someonelse20/farsight-rc/README.md

# Farsight RC

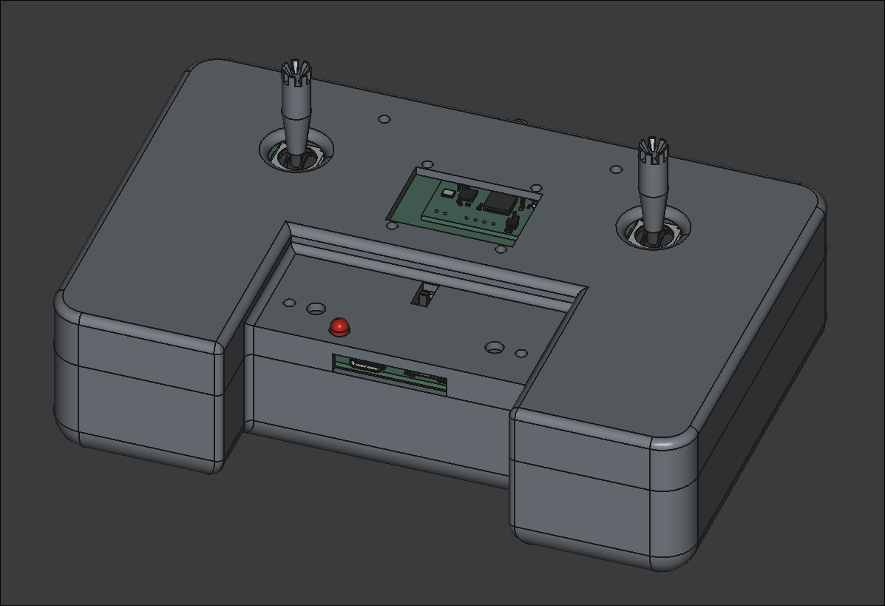
[picture p1: assets/controller-3d.png]


Custom long range remote controller with ESP32 to stream telemetry and an STM32 based lora module with the SX1262. The controller has a build in 18650 battery with an integrated charger. The transceiver is its own standalone board and can be used independenly of the controller. I made this project as a part of my larger goal to make a custom drone. I originally was going to make it out of stock modules but decided to design custom pcbs.

## Usage

**--This is still under development and is subject to change--**

### Controller

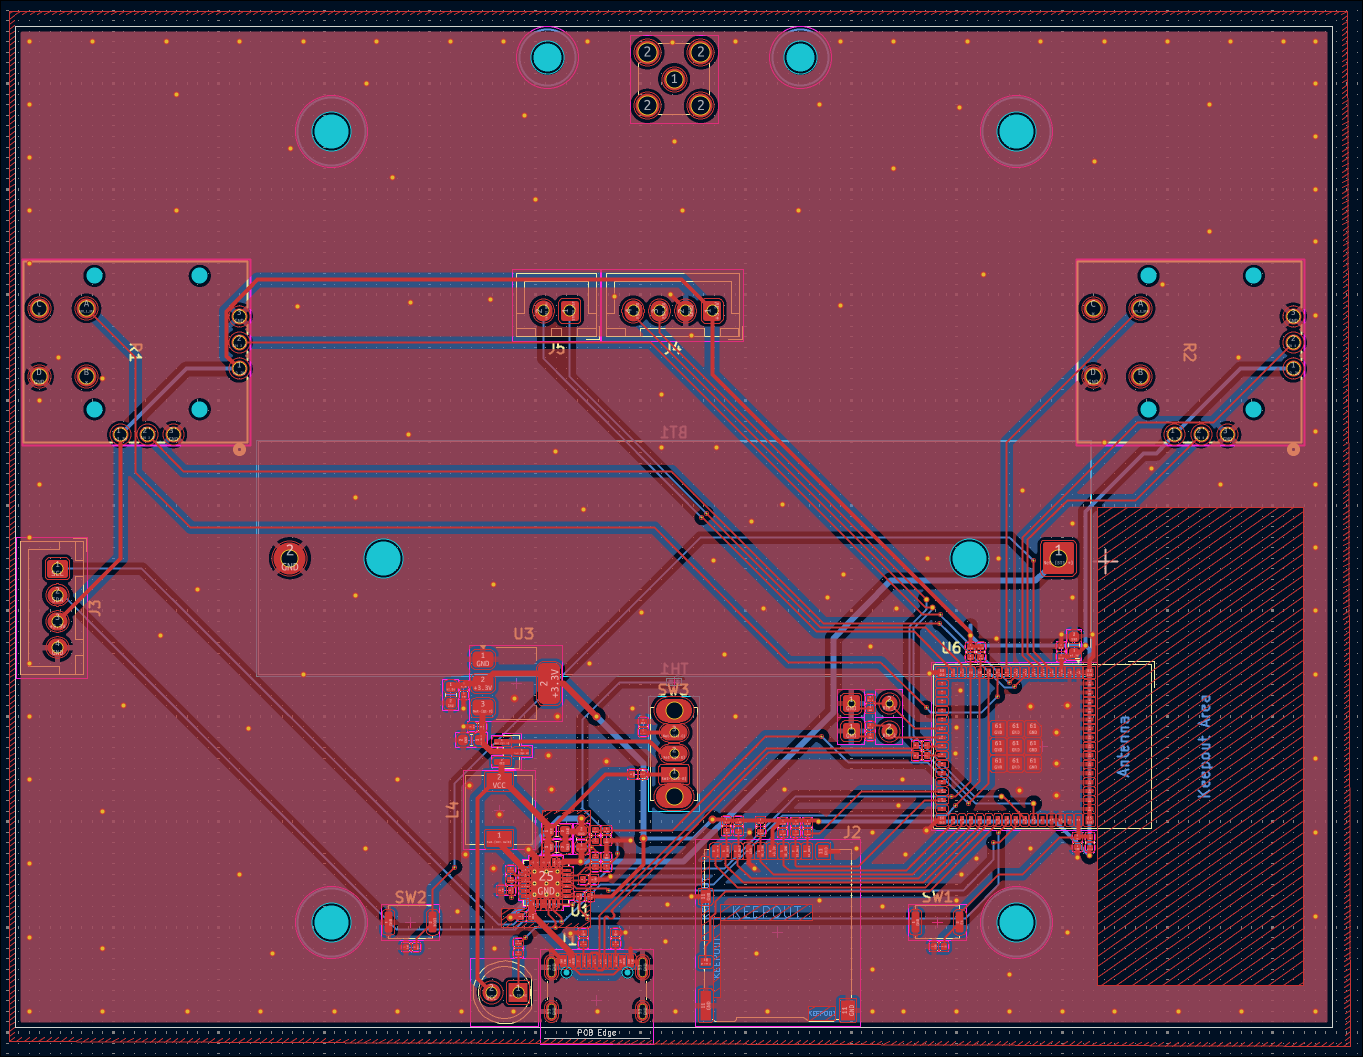
[picture p2: assets/controller_pcb.png]


The switch in the middle of the controller is the power switch and the led is the status of the battery charging. The usb connecter will charge the battery and can be used to communicate with the ESP32. The micro SD card will log all the incoming telemetry.

The controller software is currently pretty basic and missing some fetures. The wifi network the esp32 will create can be configured by installing the espressive ide and running idf.py menuconfig and changing the wifi ssid and password under Wifi Configuration. Requesting /telemetry of the ip of the nextork will return a set of comma separated values in the format of "altitude_meters,speed_meters_per_second,heading_degrees,latitude,longitude".

### Transceiver

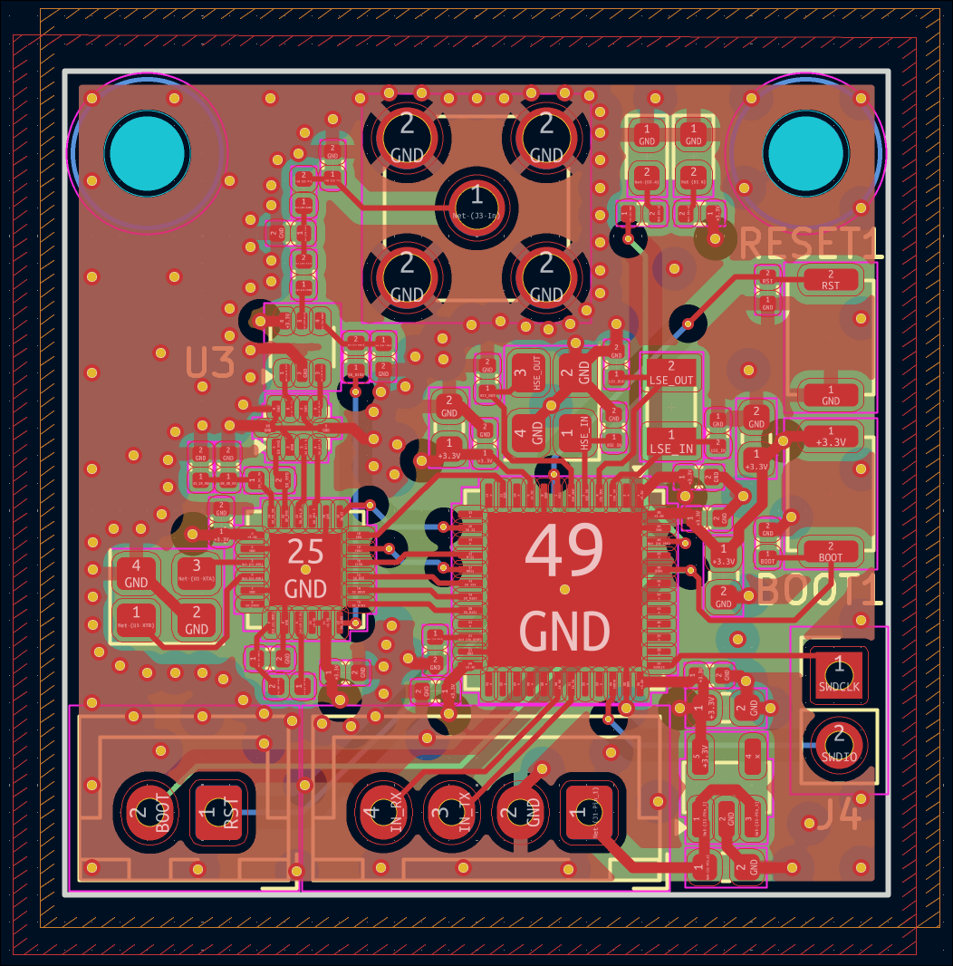
[picture p3: assets/transceiver_pcb.png]


UART pinout:
| 1 | 2 | 3 | 4 |
|-----|-----|----|----|
| VCC | GND | RX | TX |

Microcontroller pinout:
| 1 | 2 |
|---|---|
| RESET | BOOT |

Debug pinout:
| 1 | 2 |
|---|---|
| SWDCLK | SWDIO |

The transceiver has an internal regulator and can handle up to 5v input. The UART pinout is from the transceiver reference so an external device would put its Tx to the transceiver Rx and vice versa. The buttons on the board will put the STM32 into boot and reset mode respectively and the external pins are directly wired to the microcontroller.

The transceiver is built on the [Semtech SX1262 driver](https://github.com/Lora-net/sx126x_driver). To communicate with the transceiver a host must first send a register bit and then the data to transmit or receive based on the table below.
| Address | Name | Description | Input/Output | Size | Note |
|---|---|---|---|---|---|
| 0 | who_am_i | Device ID | O | 1 | Device ID is 126 |
| 1 | TX | Transmits packet | I | - | First send size byte then send data byte. |
| 2 | RX | Receives packet | I/O | - | First send size byte then send data byte. |
| 3 | TX_set | Transmits packet | I | - | Packet size must always be payload_len. |
| 4 | RX_set | Receives packet | O | - | Packet size must always be payload_len. |
| 5 | sleep | Puts transceiver into sleep mode | - | 0 | |
| 6 | wakeup | Wakes up transceiver | - | 0 | |
| 7 | set_all | Inputs a setting struct | I | TBD | See [settings_t](https://github.com/someonelse20/remote-controller/blob/main/software/transceiver/Core/Inc/uart_reg.h#L29) |
| 8 | set_frequency | Sets SX1262 frequency | I | 4 | See [sx126x_set_rf_freq](https://github.com/Lora-net/sx126x_driver/blob/master/src/sx126x.h#L1084) |
| 9 | set_tx_params | Sets SX1262 TX power and ramp time | I | 2 | array of {power in dBm, ramp time ([see datasheet](https://semtech.my.salesforce.com/sfc/p/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]))} |
| 10 | set_lora_mod_params | Sets LoRa parameters | I | TBD | See [sx126x_mod_params_lora_t](https://github.com/Lora-net/sx126x_driver/blob/master/src/sx126x.h#L381) |
| 11 | set_lora_pkt_params | Sets LoRa packet parameters | I | TBD | See [sx126x_pkt_params_lora_t](https://github.com/Lora-net/sx126x_driver/blob/master/src/sx126x.h#L454) |
| 12 | set_lora_symb_nb_timeout | Sets loRa timeout in symbols | I | 1 | See [sx126x_set_lora_symb_nb_timeout](https://github.com/Lora-net/sx126x_driver/blob/master/src/sx126x.h#L1236) |
| 13 | set_encrypt_params | Sets encryption parameters | I | - | Not currently implemented |
| 14 | enable_encrypt | Enables/disables encryption | I | - | Not currently implemented |

TBD means that the size is based on the size of a struct which will be calculated when I can run the code on the hardware.

## BOM

BOM to make two transceivers and two controllers but with only two antennas and one micro SD card.
All prices in USD. Price column is total price and does not include shipping.
| Item | Quantity | Price | Link |
|---|---|---|---|
| Controller pcb | 2 | 49.99 | https://jlcpcb.com |
| Transceiver | 2 | 87.36 | https://jlcpcb.com |
| RF filter | 2 | 0.92 | https://www.digikey.com/en/products/detail/johanson-technology-inc/0900FM15K0039001E/16639329 |
| ESP32-S3 | 2 | 5.28 | https://www.digikey.com/en/products/detail/espressif-systems/ESP32-S3-MINI-1-N8/15295890 |
| Thermistor | 2 | 0.20 | https://www.digikey.com/en/products/detail/tdk-corporation/NTCG103JF103FT1/614628 |
| Joystick | 2 | 6.08 | https://www.digikey.com/en/products/detail/c-k/THB001P/11687191 |
| RP-SMA connector | 2 | 7.40 | https://www.digikey.com/en/products/detail/taoglas-limited/PCB-RPSMAFRA-HT/5034735 |
| Antenna | 2 | 23.14 | https://www.digikey.com/en/products/detail/te-connectivity-linx/ANT-915-IPW1-RPS/15293389 |
| Power switch | 2 | 1.46 | https://www.digikey.com/en/products/detail/c-k/OS102011MS2QN1/411602 |
| Battery | 2 | 6.5 | https://www.18650batterystore.com/products/samsung-30q |
| Battery Holder | 2 | 5.56 | https://www.digikey.com/en/products/detail/mpd-memory-protection-devices/BK-18650-PC2/2079908 |
| MicroSD card | 1 | 9.99 | https://www.amazon.com/Adapter-Memory-Tablet-Console-TF162/dp/B0CYT2KL98 |
| ST-Link V2 | 1 | 9.49 | https://www.amazon.com/HiLetgo-Emulator-Downloader-Programmer-STM32F103C8T6/dp/B07SQV6VLZ |
| OLED display | 1 | 6.99 | https://www.amazon.com/UCTRONICS-SSD1306-Self-Luminous-Display-Raspberry/dp/B072Q2X2LL |
