someonelse20/farsight-rc/assets/controller_pcb-3d.png

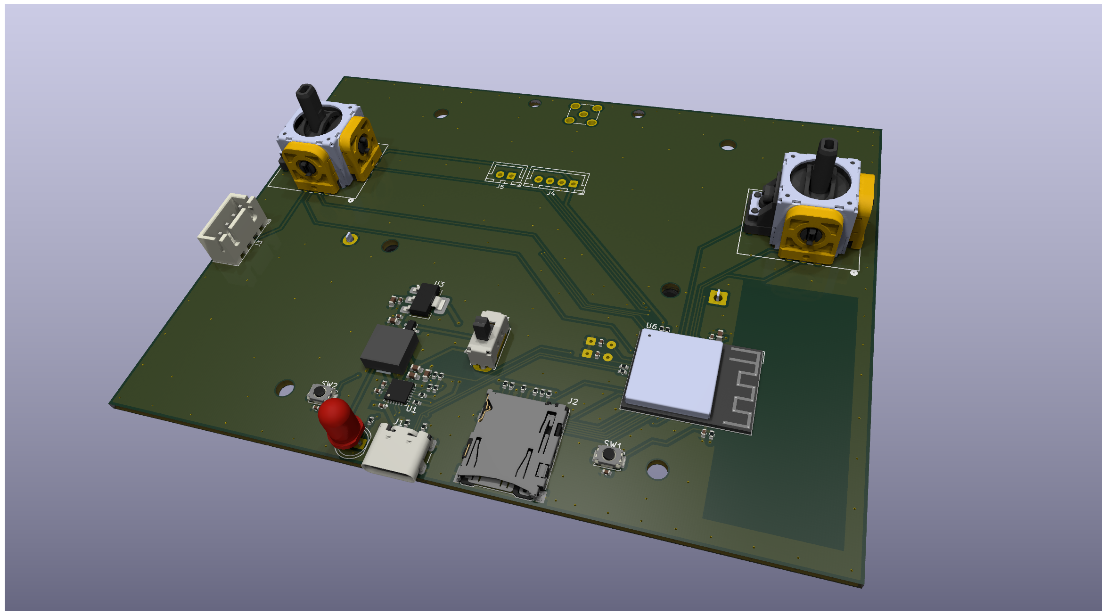
assets/controller_pcb-3d.png
