someonelse20/farsight-rc/assets/controller_schematic.png

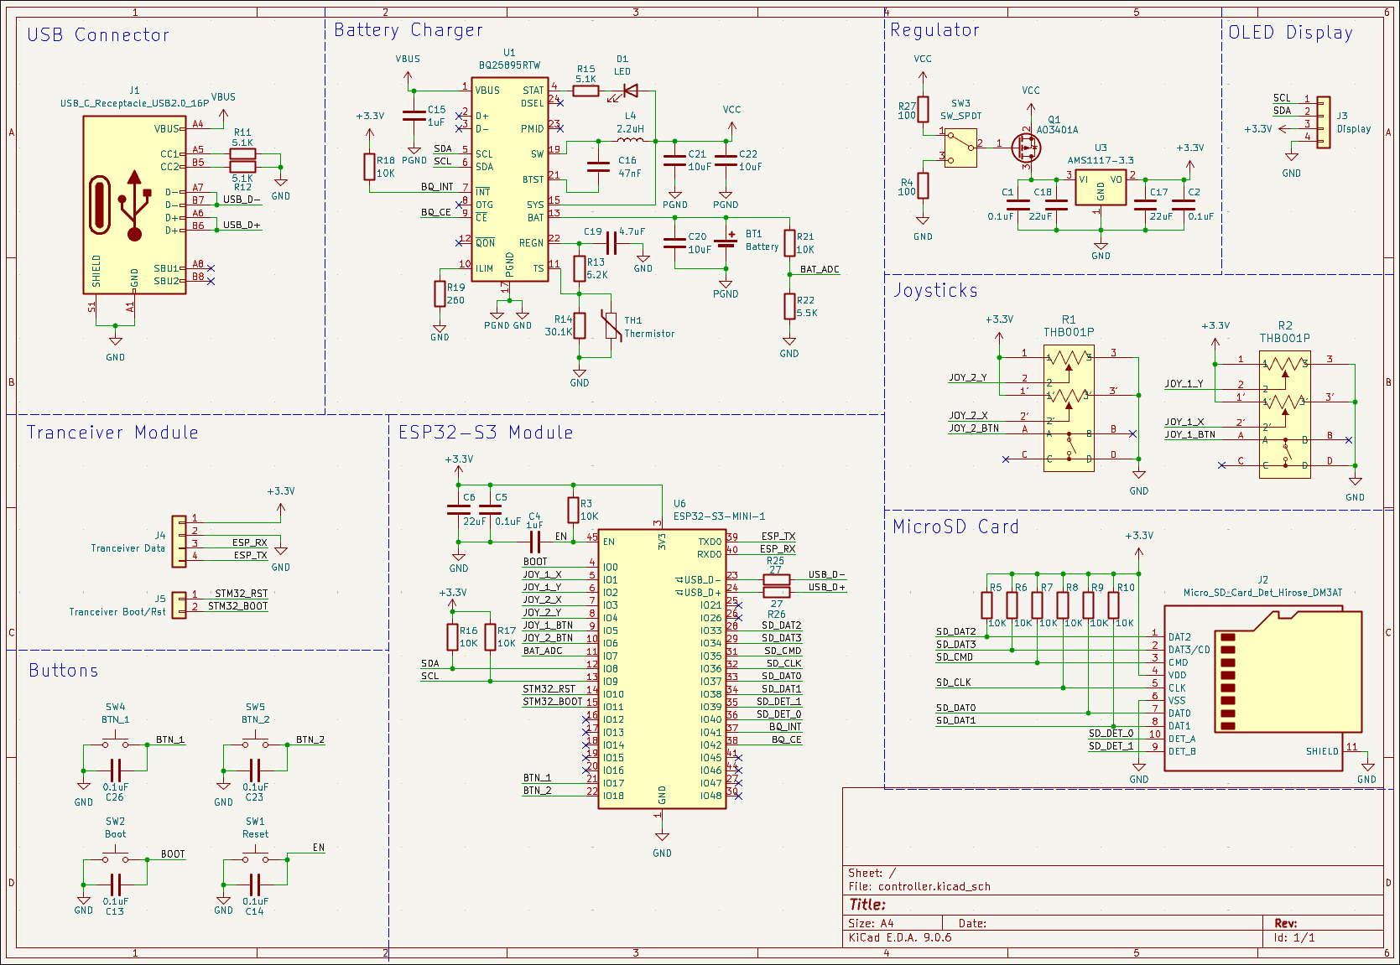
assets/controller_schematic.png
