someonelse20/farsight-rc/assets/transceiver_pcb-3d.png

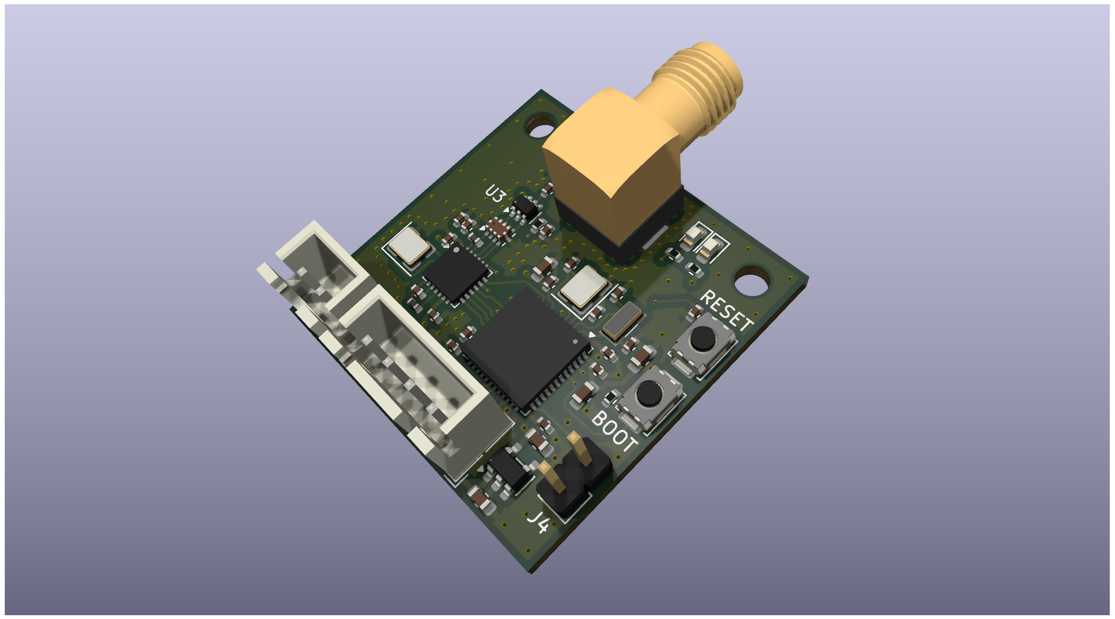
assets/transceiver_pcb-3d.png
