someonelse20/farsight-rc/assets/transceiver_schematic.png

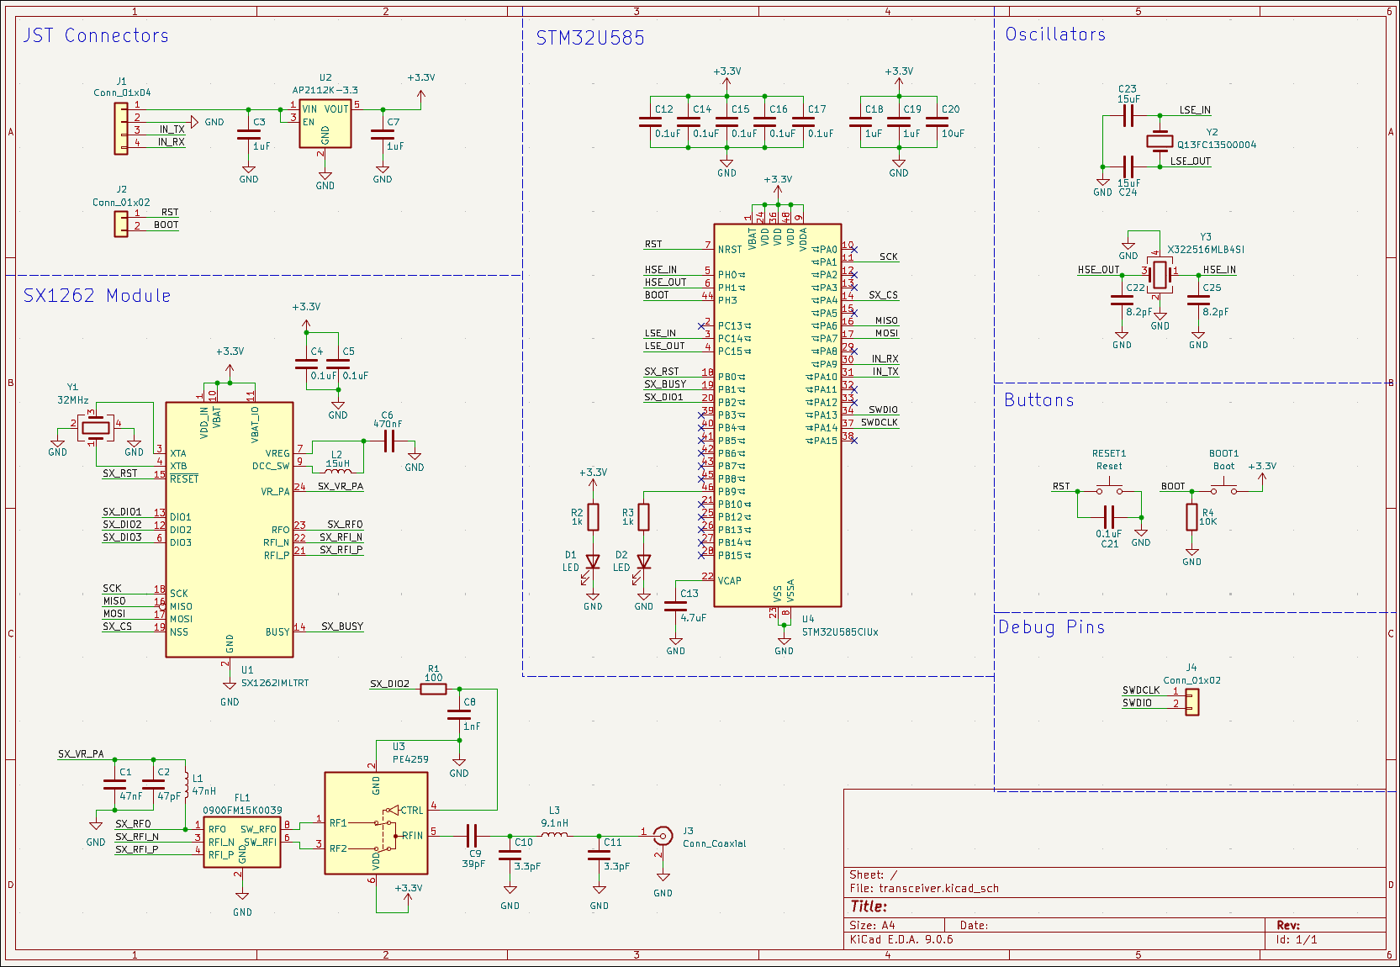
assets/transceiver_schematic.png
