someonelse20/farsight-rc/hardware/controller/controller-3d-back.png

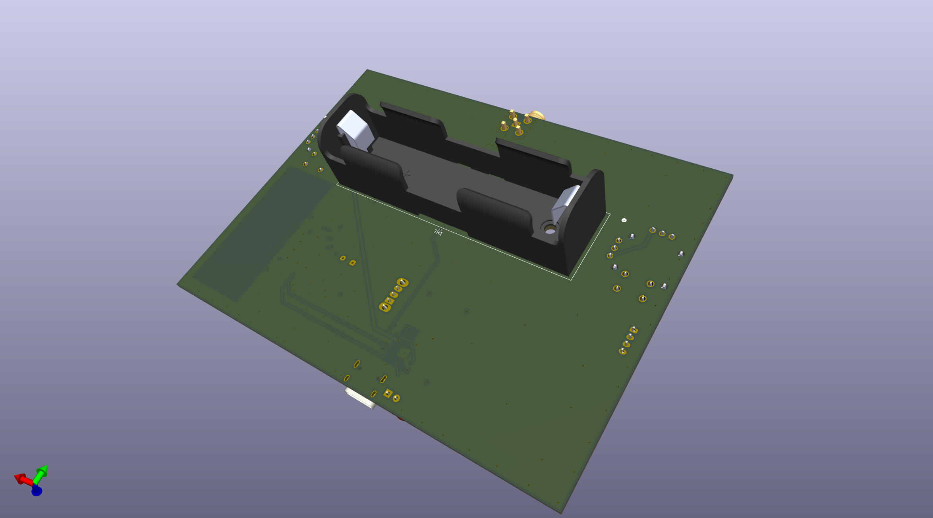
hardware/controller/controller-3d-back.png
