someonelse20/farsight-rc/hardware/controller/controller-3d-front.png

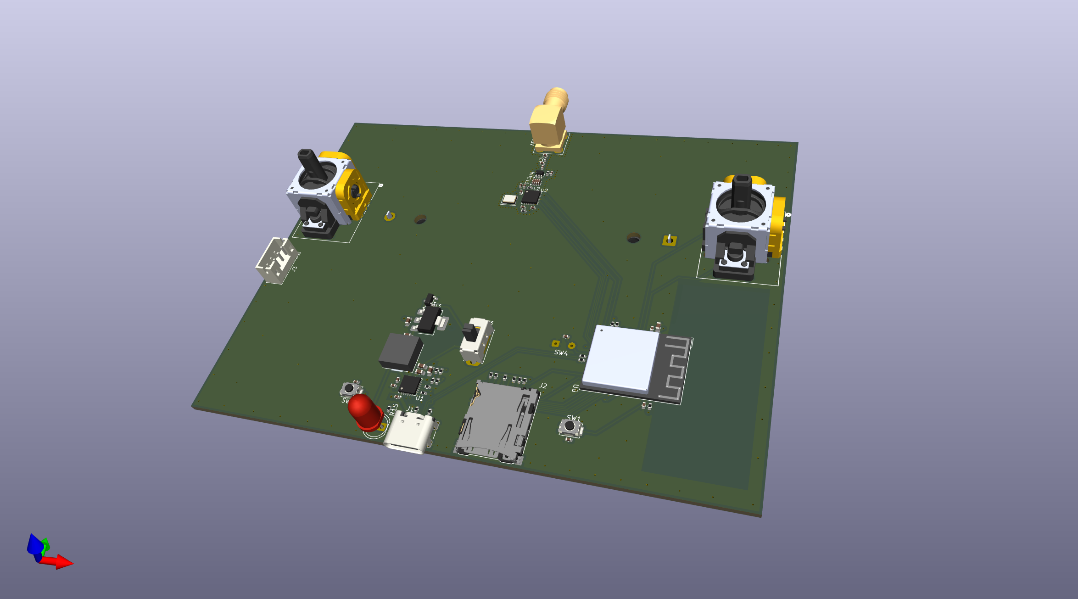
hardware/controller/controller-3d-front.png
