someonelse20/farsight-rc/hardware/transceiver/transceiver-3d.png

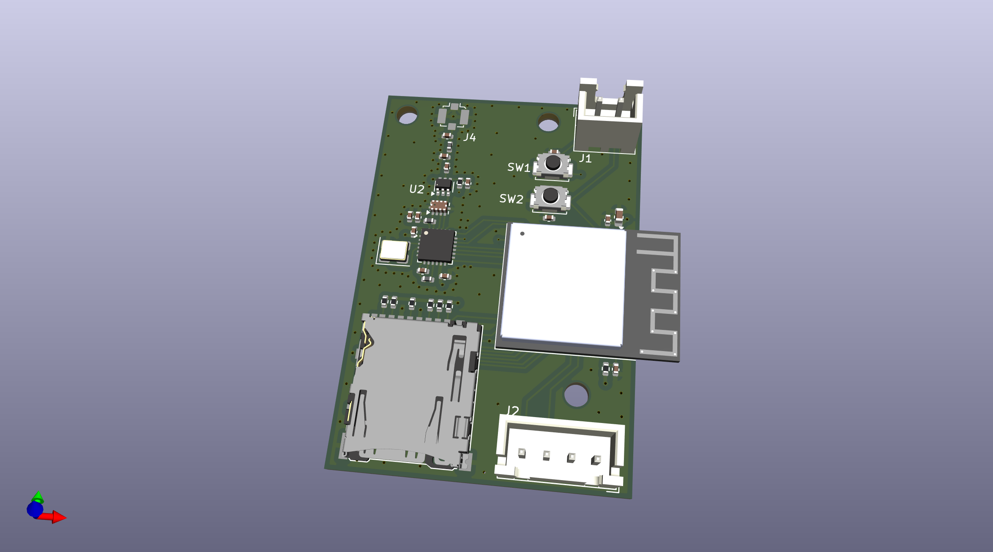
hardware/transceiver/transceiver-3d.png
