someonelse20/farsight-rc/hardware/cad/production/joystick_cap.3mf

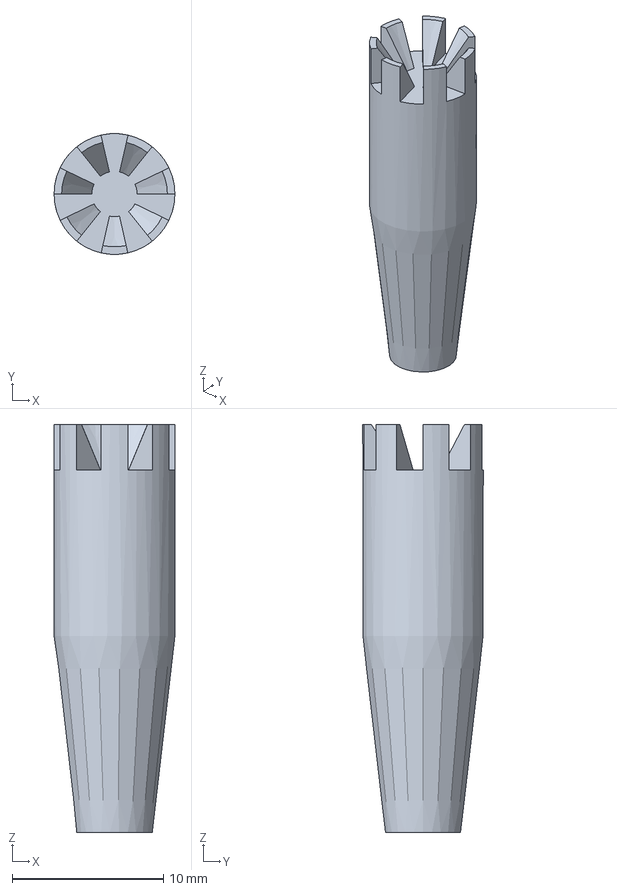
[picture p11: CAD file, 2026-02-26]
hardware/cad/production/joystick_cap.3mf
8.00 x 7.98 x 27.0 mm
