someonelse20/farsight-rc/hardware/cad/shell.FCStd

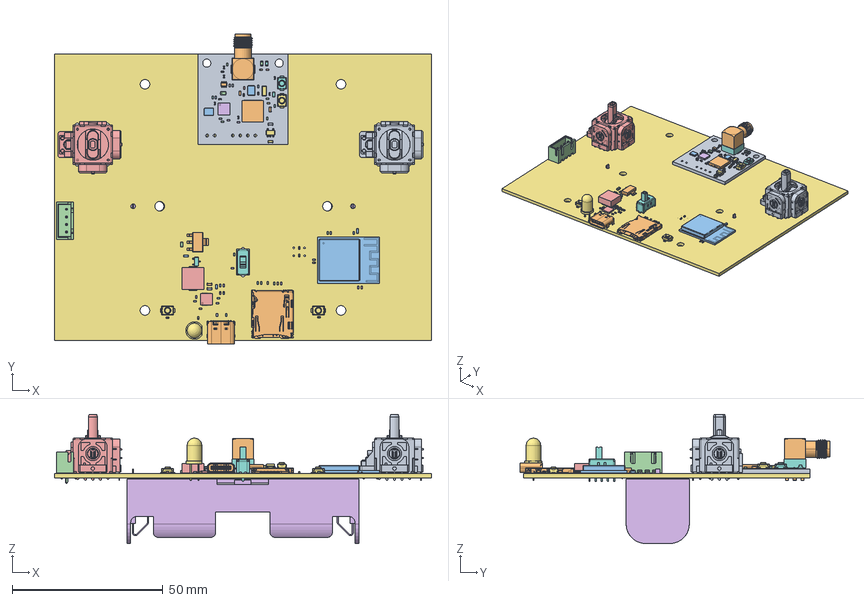
[picture p12: CAD file, 2026-03-07]
hardware/cad/shell.FCStd
125.0 x 102.7 x 42.8 mm
THB001P
R_0402_1005Metric
C_0603_1608Metric
R_0402_1005Metric017
THB001P001
C_0402_1005Metric
R_0402_1005Metric018
R_0402_1005Metric019
R_0402_1005Metric020
R_0402_1005Metric021
R_0402_1005Metric022
C_0603_1608Metric011
Texas_RTW_WQFN-24-1EP_4x4mm_P0.5mm_EP2.7x2.7mm
R_0402_1005Metric023
SW_Push_SPST_NO_Alps_SKRK002
C_0402_1005Metric027
C_0603_1608Metric012
SOT-223
C_0603_1608Metric013
R_0402_1005Metric024
R_0402_1005Metric025
C_0402_1005Metric028
LED_D5.0mm
R_0402_1005Metric026
C_0402_1005Metric029
USB_C_Receptacle_GCT_USB4105-xx-A_16P_TopMnt_Horizontal
C_0402_1005Metric030
JST_XH_B4B-XH-A_1x04_P2.50mm_Vertical
Pins001
R_0402_1005Metric027
SOT-23
R_0402_1005Metric028
C_0402_1005Metric031
ESP32-S3-MINI-1-N8
R_0402_1005Metric029
C_0402_1005Metric032
R_0402_1005Metric030
C_0402_1005Metric033
SW_Slide_SPDT_Straight_CK_OS102011MS2Q
R_0402_1005Metric031
microSD_HC_Hirose_DM3AT-SF-PEJM5
C_0603_1608Metric014
R_0402_1005Metric032
R_0402_1005Metric033
R_0402_1005Metric034
SW_Push_SPST_NO_Alps_SKRK003
R_0402_1005Metric035
R_0402_1005Metric036
C_0603_1608Metric015
R_0402_1005Metric037
C_0402_1005Metric034
R_0201_0603Metric
BK-18650-PC2
controller_PCB
C_0402_1005Metric007
C_0603_1608Metric006
C_0603_1608Metric007
C_0402_1005Metric008
C_0402_1005Metric009
C_0402_1005Metric010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
