someonelse20/farsight-rc/hardware/controller/controller.step

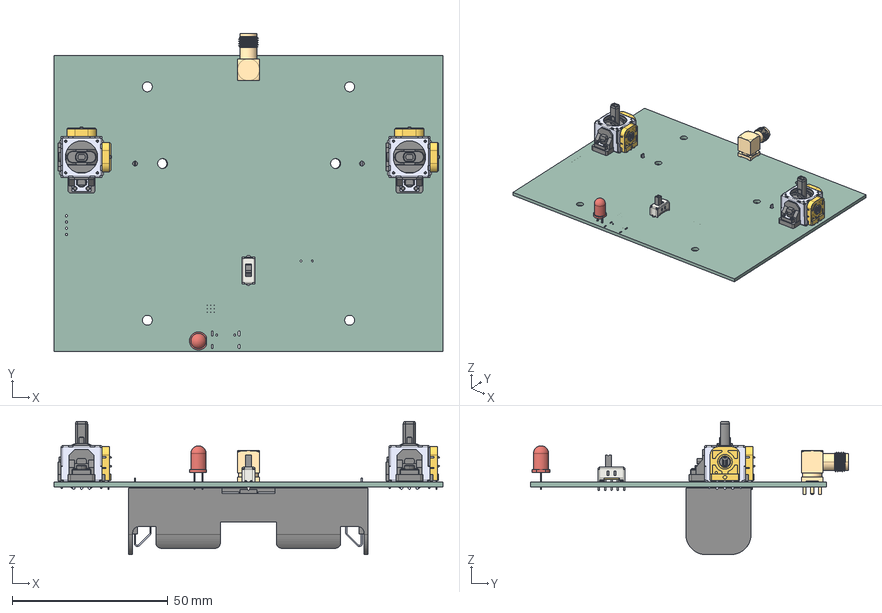
[picture p13: CAD file, 2026-02-16]
hardware/controller/controller.step
125.0 x 102.1 x 42.8 mm
THB001P x 2
LED_D5.0mm
RFPC-SMA27-F
SW_Slide_SPDT_Straight_CK_OS102011MS2Q
BK-18650-PC2
controller_PCB
