someonelse20/farsight-rc/production/cad/bottom_shell.step

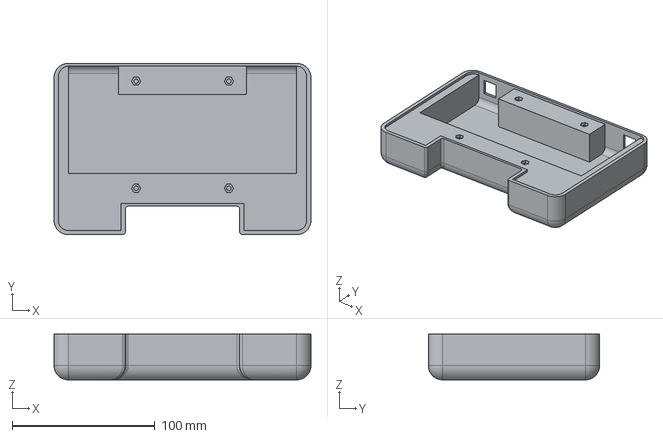
[picture p14: CAD file, 2026-03-07]
production/cad/bottom_shell.step
180.0 x 120.0 x 32.0 mm
