someonelse20/farsight-rc/hardware/cad/production/test-Body.3mf

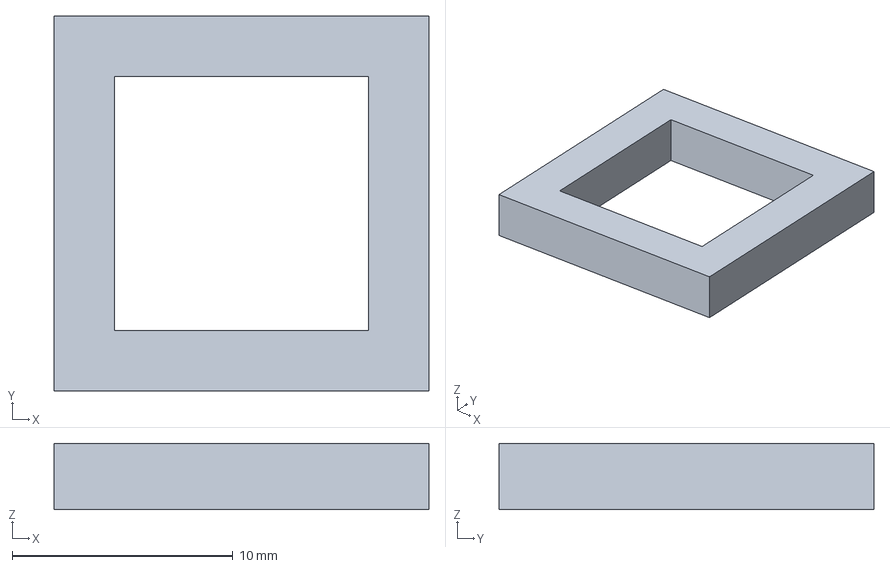
[picture p15: CAD file, 2026-02-18]
hardware/cad/production/test-Body.3mf
17.0 x 17.0 x 3.00 mm
