someonelse20/farsight-rc/hardware/cad/top_shell.FCStd

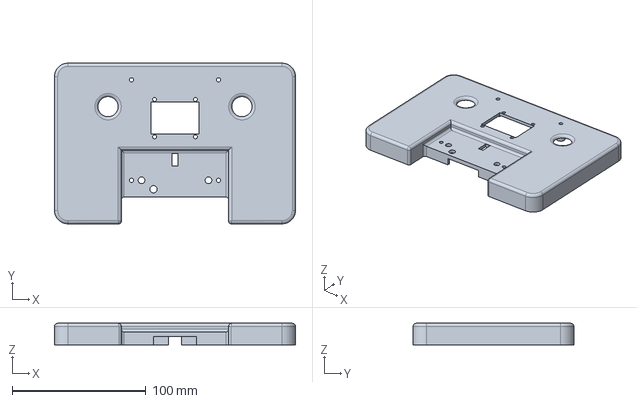
[picture p16: CAD file, 2026-03-05]
hardware/cad/top_shell.FCStd
180.0 x 120.0 x 16.1 mm
