someonelse20/farsight-rc/hardware/cad/production/top_shell.3mf

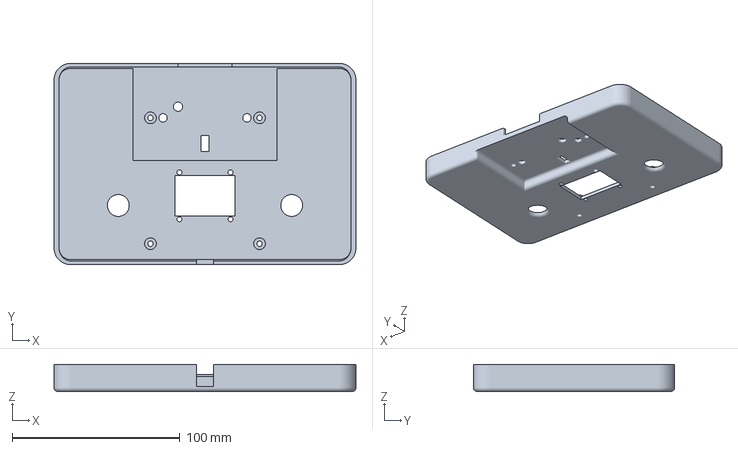
[picture p17: CAD file, 2026-02-16]
hardware/cad/production/top_shell.3mf
180.0 x 120.0 x 16.1 mm
