someonelse20/farsight-rc/hardware/cad/transceiver.step

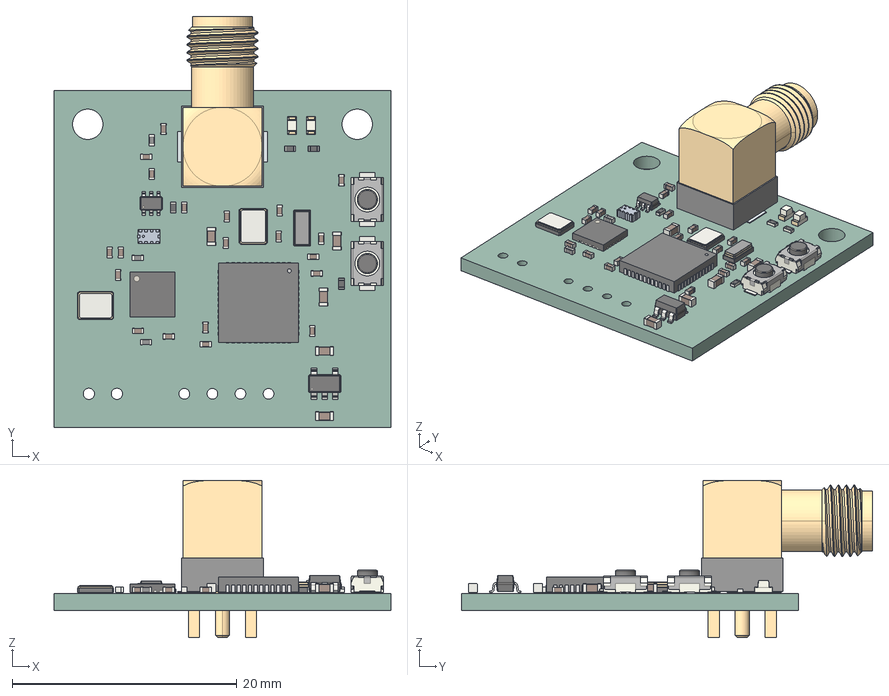
[picture p18: CAD file, 2026-02-24]
hardware/cad/transceiver.step
30.0 x 36.6 x 14.0 mm
C_0402_1005Metric x 20
C_0603_1608Metric x 5
Pins
RFPC-SMA27-F
Crystal_SMD_3225-4Pin_3.2x2.5mm x 2
R_0402_1005Metric x 4
LED_0603_1608Metric x 2
SOT-363_SC-70-6
QFN-24-1EP_4x4mm_P0.5mm_EP2.6x2.6mm
L_0402_1005Metric x 3
SOT-23-5
SW_Push_SPST_NO_Alps_SKRK x 2
transceiver 1.36.1
transceiver 1.36.2
transceiver 1.36.3
Crystal_SMD_3215-2Pin_3.2x1.5mm
UFQFPN-48_7X7X0P5MM_STM
transceiver_PCB
