someonelse20/farsight-rc/(list of files, cad)

Other CAD files:
production/cad/top_shell.step
hardware/cad/joystick_cap.FCStd
hardware/cad/production/bottom_shell.3mf
production/cad/joystick_cap.step
hardware/cad/bottom_shell.FCStd
hardware/cad/test.FCStd
