someonelse20/farsight-rc/hardware/controller/controller.pdf

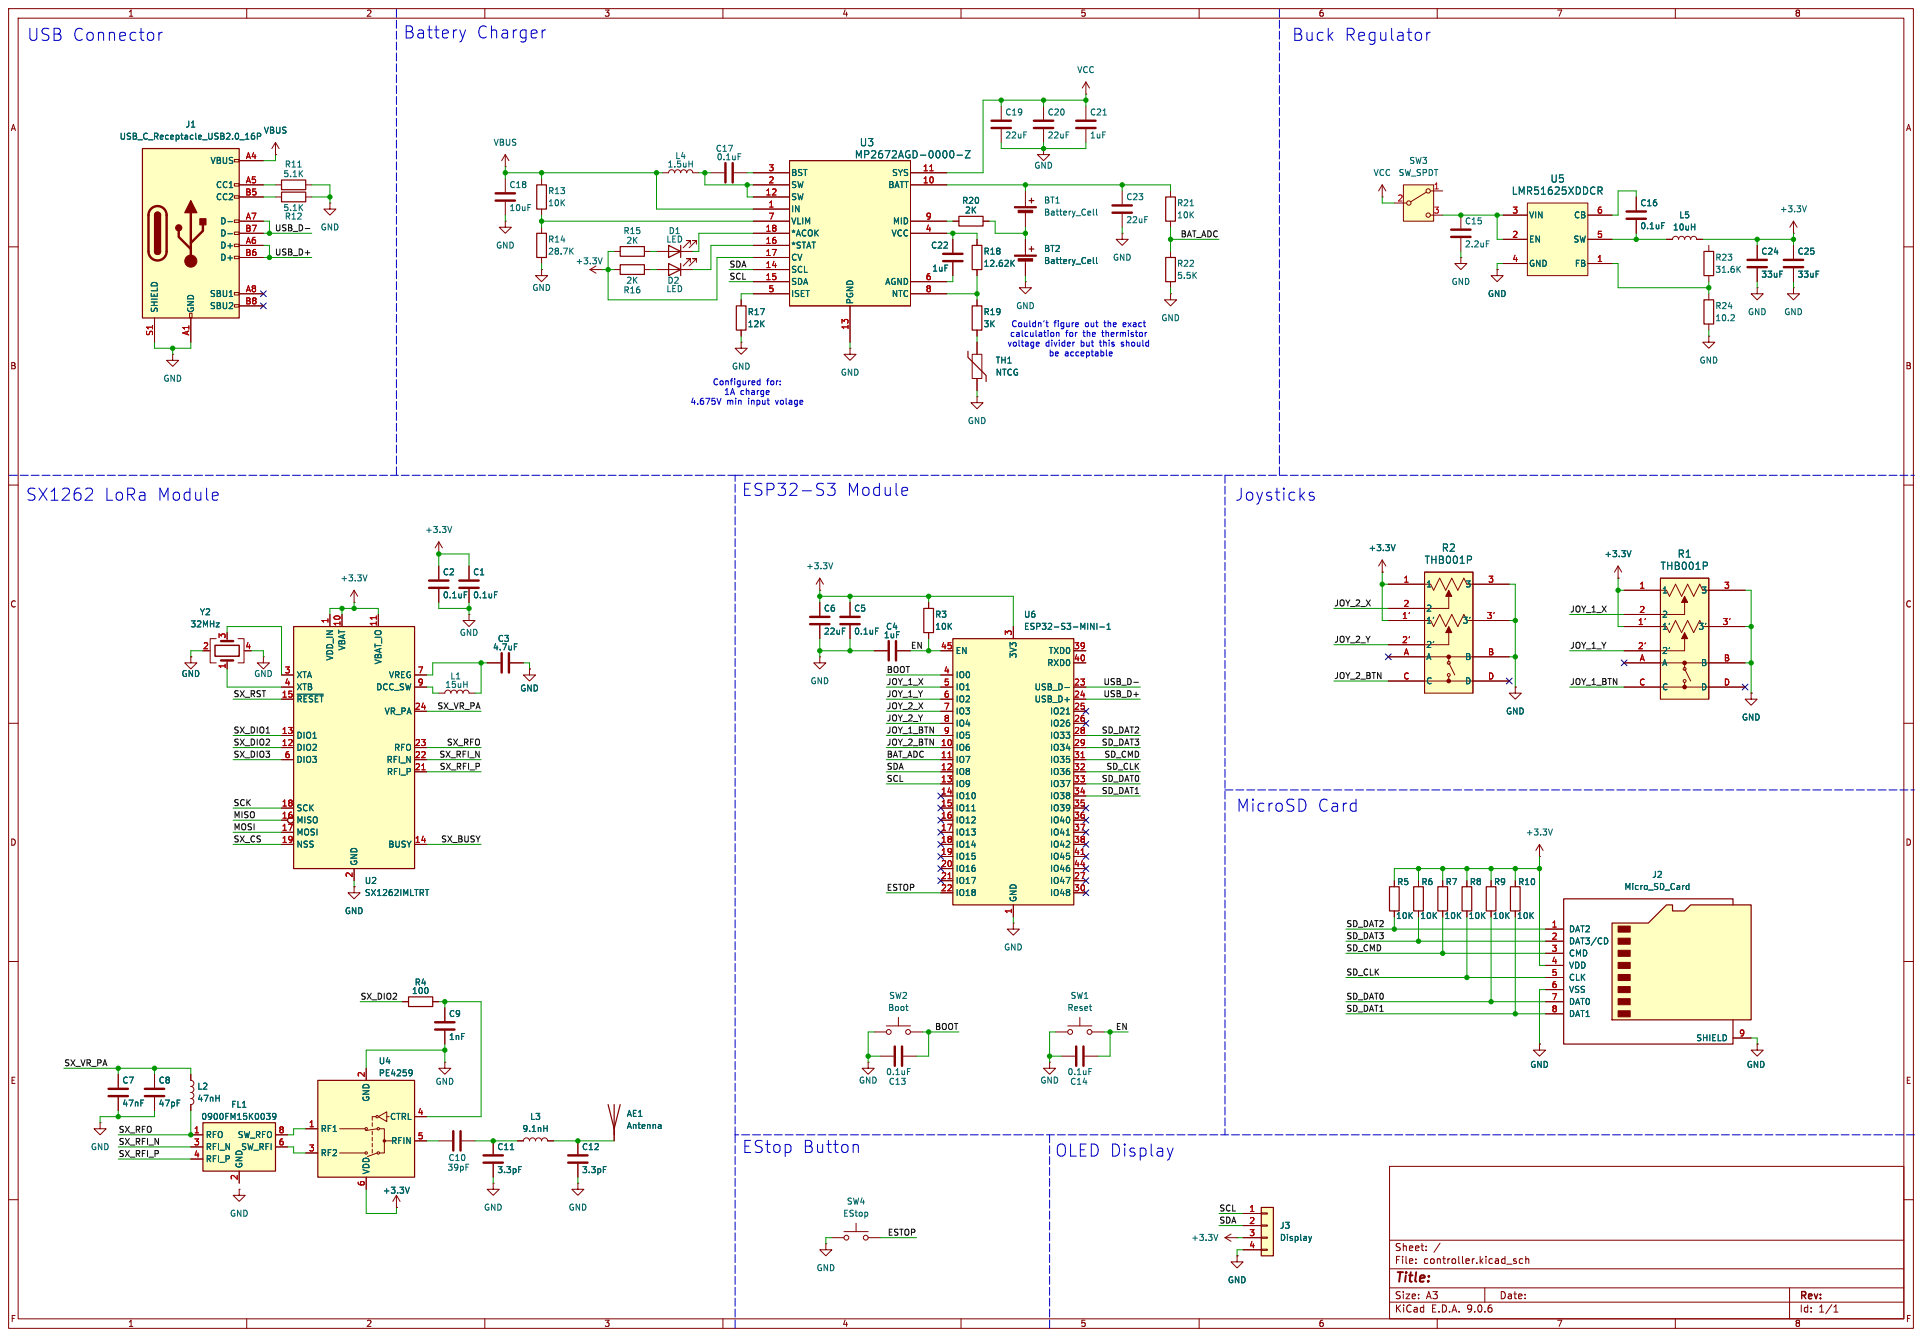
[picture p19: page 1]

Id: 1/1 Title: File: controller.kicad_sch Sheet: / L2
