someonelse20/farsight-rc/hardware/controller/controller.kicad_pcb

## KiCad design hardware/controller/controller.kicad_pcb (2026-04-02)

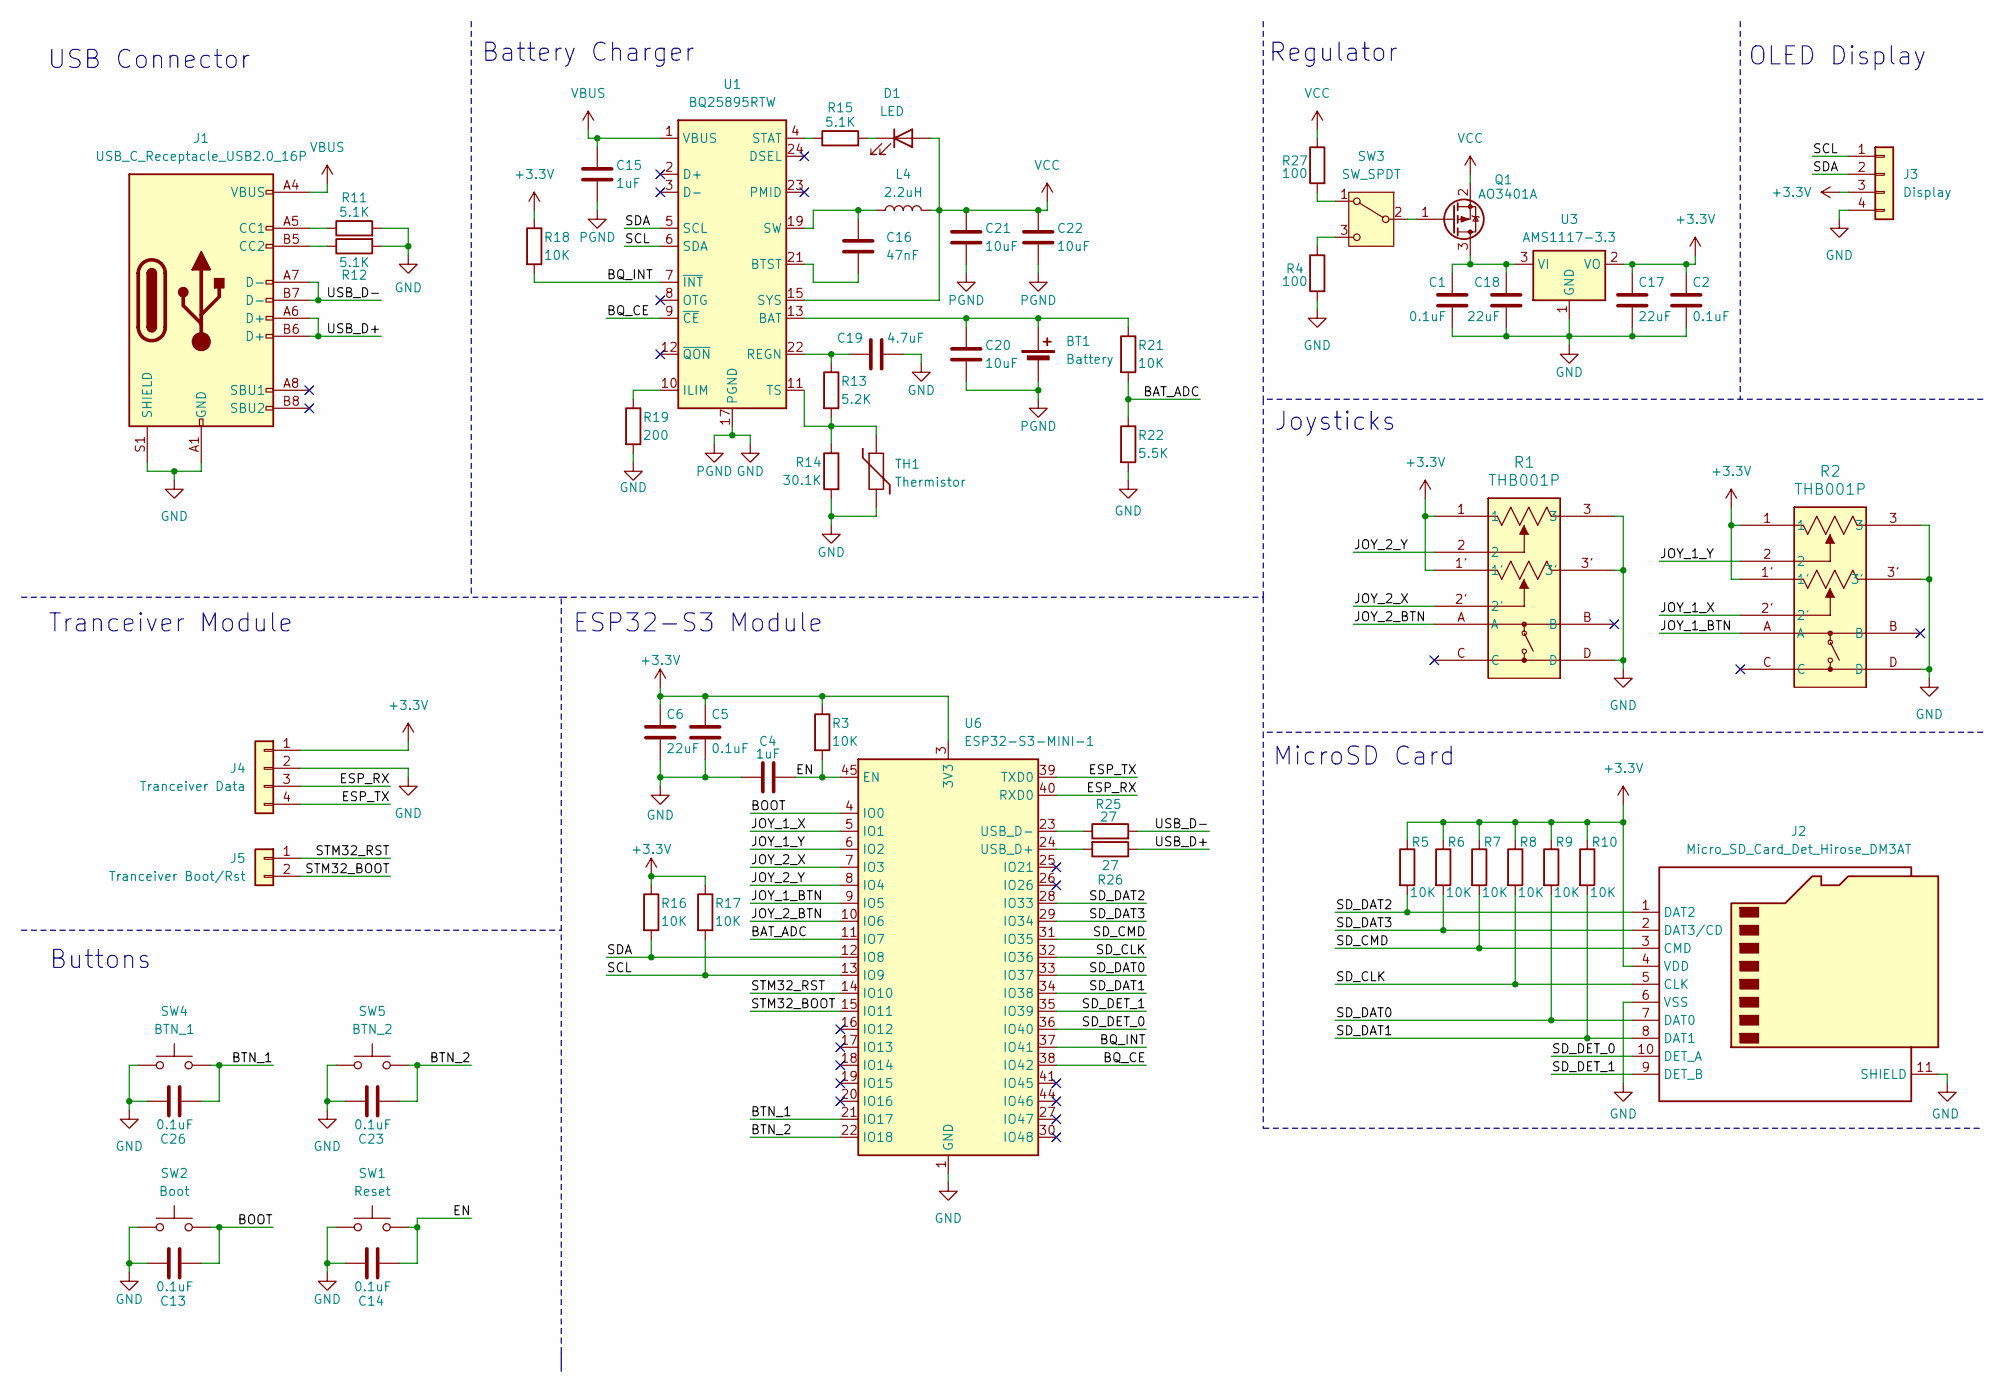
[picture p20: schematic controller.kicad_sch]

Parts:
BT1: Battery; BatteryHolder_MPD_BH-18650-PC
C1, C2, C5, C13, C14, C23, C26: 0.1uF; C_0402_1005Metric
C4, C15: 1uF; C_0402_1005Metric
C6, C17, C18: 22uF; C_0603_1608Metric
C16: 47nF; C_0402_1005Metric
C19: 4.7uF; C_0402_1005Metric
C20, C21, C22: 10uF; C_0603_1608Metric
D1: LED; LED_D5.0mm
J1: USB_C_Receptacle_USB2.0_16P; USB_C_Receptacle_GCT_USB4105-xx-A_16P_TopMnt_Horizontal
J2: Micro_SD_Card_Det_Hirose_DM3AT; microSD_HC_Hirose_DM3AT-SF-PEJM5
J3: Display; JST_XH_B4B-XH-A_1x04_P2.50mm_Vertical
J4: Tranceiver Data; JST_XH_B4B-XH-A_1x04_P2.50mm_Vertical
J5: Tranceiver Boot/Rst; JST_XH_B2B-XH-A_1x02_P2.50mm_Vertical
L4: 2.2uH; L_6.3x6.3_H3
Q1: AO3401A; SOT-23
R1, R2: THB001P; THB001P_CNK
R3, R5, R6, R7, R8, R9, R10, R16, R17, R18, R21: 10K; R_0402_1005Metric
R4, R27: 100; R_0402_1005Metric
R11, R12, R15: 5.1K; R_0402_1005Metric
R13: 5.2K; R_0402_1005Metric
R14: 30.1K; R_0402_1005Metric
R19: 200; R_0402_1005Metric
R22: 5.5K; R_0402_1005Metric
R25, R26: 27; R_0402_1005Metric
SW1: Reset; SW_Push_SPST_NO_Alps_SKRK
SW2: Boot; SW_Push_SPST_NO_Alps_SKRK
SW3: SW_SPDT; SW_Slide_SPDT_Straight_CK_OS102011MS2Q
SW4: BTN_1; SolderWire-0.1sqmm_1x02_P3.6mm_D0.4mm_OD1mm
SW5: BTN_2; SolderWire-0.1sqmm_1x02_P3.6mm_D0.4mm_OD1mm
TH1: Thermistor; R_0201_0603Metric
U1: BQ25895RTW; Texas_RTW_WQFN-24-1EP_4x4mm_P0.5mm_EP2.7x2.7mm_ThermalVias
U3: AMS1117-3.3; SOT-223-3_TabPin2
U6: ESP32-S3-MINI-1; ESP32-S2-MINI-1

Connections:
+3.3V: C2.1, C5.1, C6.1, C17.1, J2.4 (VDD), J3.3, J4.1, R1.1, R1.1', R2.1, R2.1', R3.1, R5.1, R6.1, R7.1, R8.1, R9.1, R10.1, R16.1, R17.1, R18.1, U3.2 (VO), U6.3 (3V3)
/BAT_ADC: R21.2, R22.1, U6.11 (IO7)
/BOOT: C13.2, SW2.2, U6.4 (IO0)
/BQ_CE: U1.9 (~CE), U6.38 (IO42)
/BQ_INT: R18.2, U1.7 (~INT), U6.37 (IO41)
/BTN_1: C26.2, SW4.2, U6.21 (IO17)
/BTN_2: C23.2, SW5.2, U6.22 (IO18)
/EN: C4.2, C14.2, R3.2, SW1.2, U6.45 (EN)
/ESP_RX: J4.3, U6.40 (RXD0)
/ESP_TX: J4.4, U6.39 (TXD0)
/JOY_1_BTN: R2.A, U6.9 (IO5)
/JOY_1_X: R2.2', U6.5 (IO1)
/JOY_1_Y: R2.2, U6.6 (IO2)
/JOY_2_BTN: R1.A, U6.10 (IO6)
/JOY_2_X: R1.2', U6.7 (IO3)
/JOY_2_Y: R1.2, U6.8 (IO4)
/SCL: J3.1, R17.2, U1.6 (SDA), U6.13 (IO9)
/SDA: J3.2, R16.2, U1.5 (SCL), U6.12 (IO8)
/SD_CLK: J2.5 (CLK), R8.2, U6.32 (IO36)
/SD_CMD: J2.3 (CMD), R7.2, U6.31 (IO35)
/SD_DAT0: J2.7 (DAT0), R9.2, U6.33 (IO37)
/SD_DAT1: J2.8 (DAT1), R10.2, U6.34 (IO38)
/SD_DAT2: J2.1 (DAT2), R5.2, U6.28 (IO33)
/SD_DAT3: J2.2 (DAT3/CD), R6.2, U6.29 (IO34)
/SD_DET_0: J2.10 (DET_A), U6.36 (IO40)
/SD_DET_1: J2.9 (DET_B), U6.35 (IO39)
/STM32_BOOT: J5.2, U6.15 (IO11)
/STM32_RST: J5.1, U6.14 (IO10)
/USB_D+: J1.A6 (D+), J1.B6 (D+), R26.1
/USB_D-: J1.A7 (D-), J1.B7 (D-), R25.2
GND: BT1.2 (-), C1.2, C2.2, C4.1, C5.2, C6.2, C13.1, C14.1, C15.2, C17.2, C18.2, C19.2, C20.2, C21.2, C22.2, C23.1, C26.1, J1.A1 (GND), J1.A12 (GND), J1.B1 (GND), J1.B12 (GND), J1.S1 (SHIELD), J2.6 (VSS), J2.11 (SHIELD), J3.4, J4.2, R1.3, R1.3', R1.D, R2.3, R2.3', R2.D, R4.2, R11.2, R12.2, R14.2, R19.2, R22.2, SW1.1, SW2.1, SW4.1, SW5.1, TH1.2, U1.17 (PGND), U1.18 (PGND), U1.25 (PGND), U3.1 (GND), U6.1 (GND), U6.2 (GND), U6.42 (GND), U6.43 (GND), U6.46 (GND), U6.47 (GND), U6.48 (GND), U6.49 (GND), U6.50 (GND), U6.51 (GND), U6.52 (GND), U6.53 (GND), U6.54 (GND), U6.55 (GND), U6.56 (GND), U6.57 (GND), U6.58 (GND), U6.59 (GND), U6.60 (GND), U6.61 (GND), U6.62 (GND), U6.63 (GND), U6.64 (GND), U6.65 (GND)
unnamed: BT1.1 (+), C20.1, R21.1, U1.13 (BAT), U1.14 (BAT)
unnamed: C16.1, L4.1, U1.19 (SW), U1.20 (SW)
unnamed: D1.1 (K), R15.2
unnamed: J1.A5 (CC1), R11.1
unnamed: J1.B5 (CC2), R12.1
unnamed: C1.1, C18.1, Q1.3 (D), U3.3 (VI)
unnamed: Q1.1 (G), SW3.2 (B)
unnamed: R27.2, SW3.1 (A)
unnamed: R4.1, SW3.3 (C)
unnamed: C16.2, U1.21 (BTST)
unnamed: R19.1, U1.10 (ILIM)
unnamed: C19.1, R13.1, U1.22 (REGN)
unnamed: R15.1, U1.4 (STAT)
unnamed: R13.2, R14.1, TH1.1, U1.11 (TS)
unnamed: R26.2, U6.24 (USB_D+)
unnamed: R25.1, U6.23 (USB_D-)
VBUS: C15.1, J1.A4 (VBUS), J1.A9 (VBUS), J1.B4 (VBUS), J1.B9 (VBUS), U1.1 (VBUS)
VCC: C21.1, C22.1, D1.2 (A), L4.2, Q1.2 (S), R27.1, U1.15 (SYS), U1.16 (SYS)

Notes on the sheet:
Regulator
ESP32-S3 Module
Joysticks
Buttons
USB Connector
Battery Charger
Tranceiver Module
OLED Display
MicroSD Card

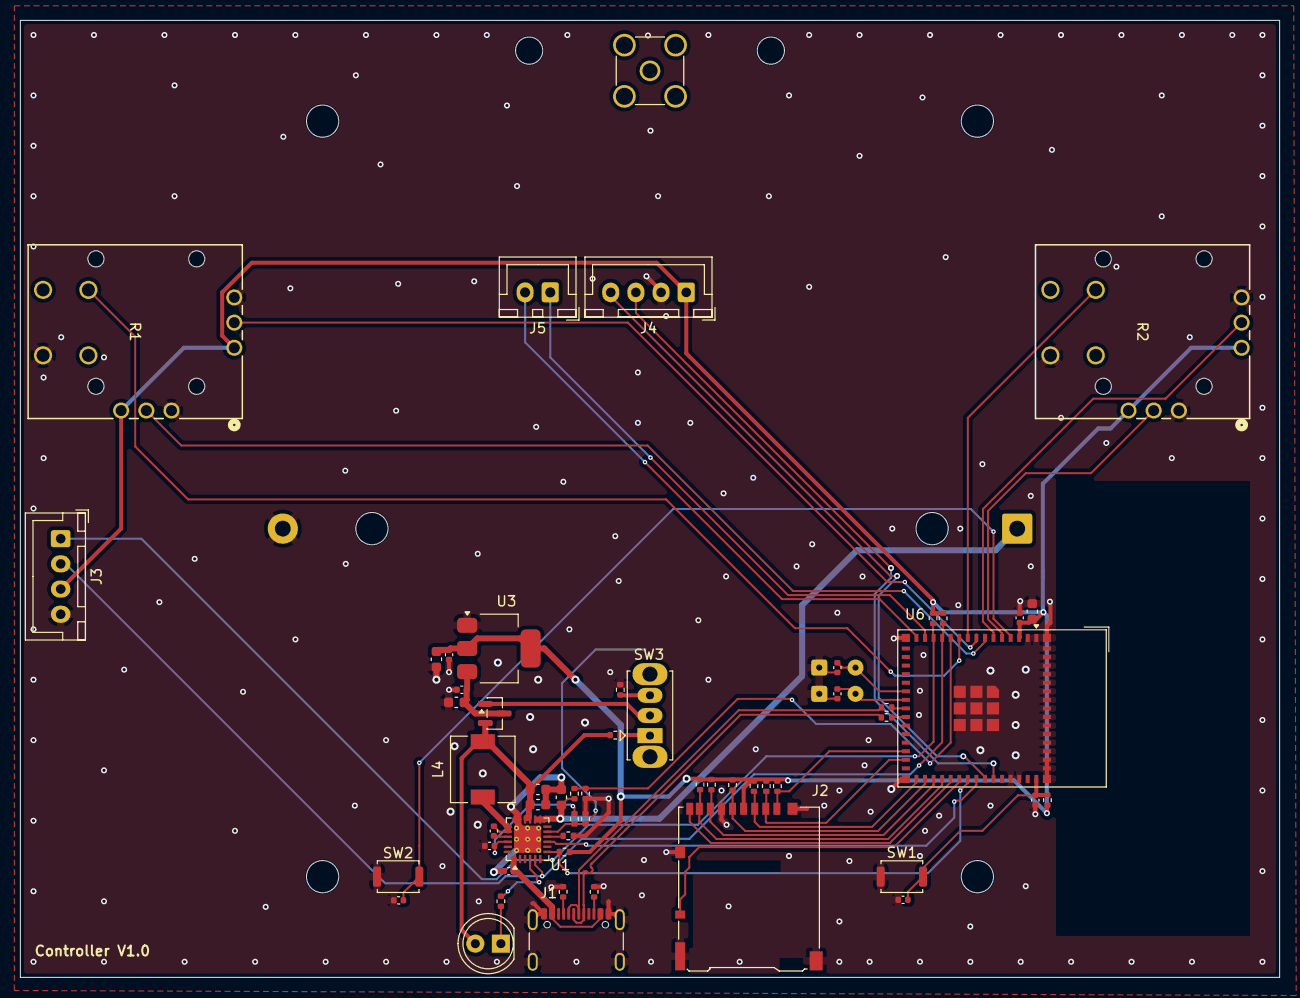
[picture p21: board controller.kicad_pcb from above]

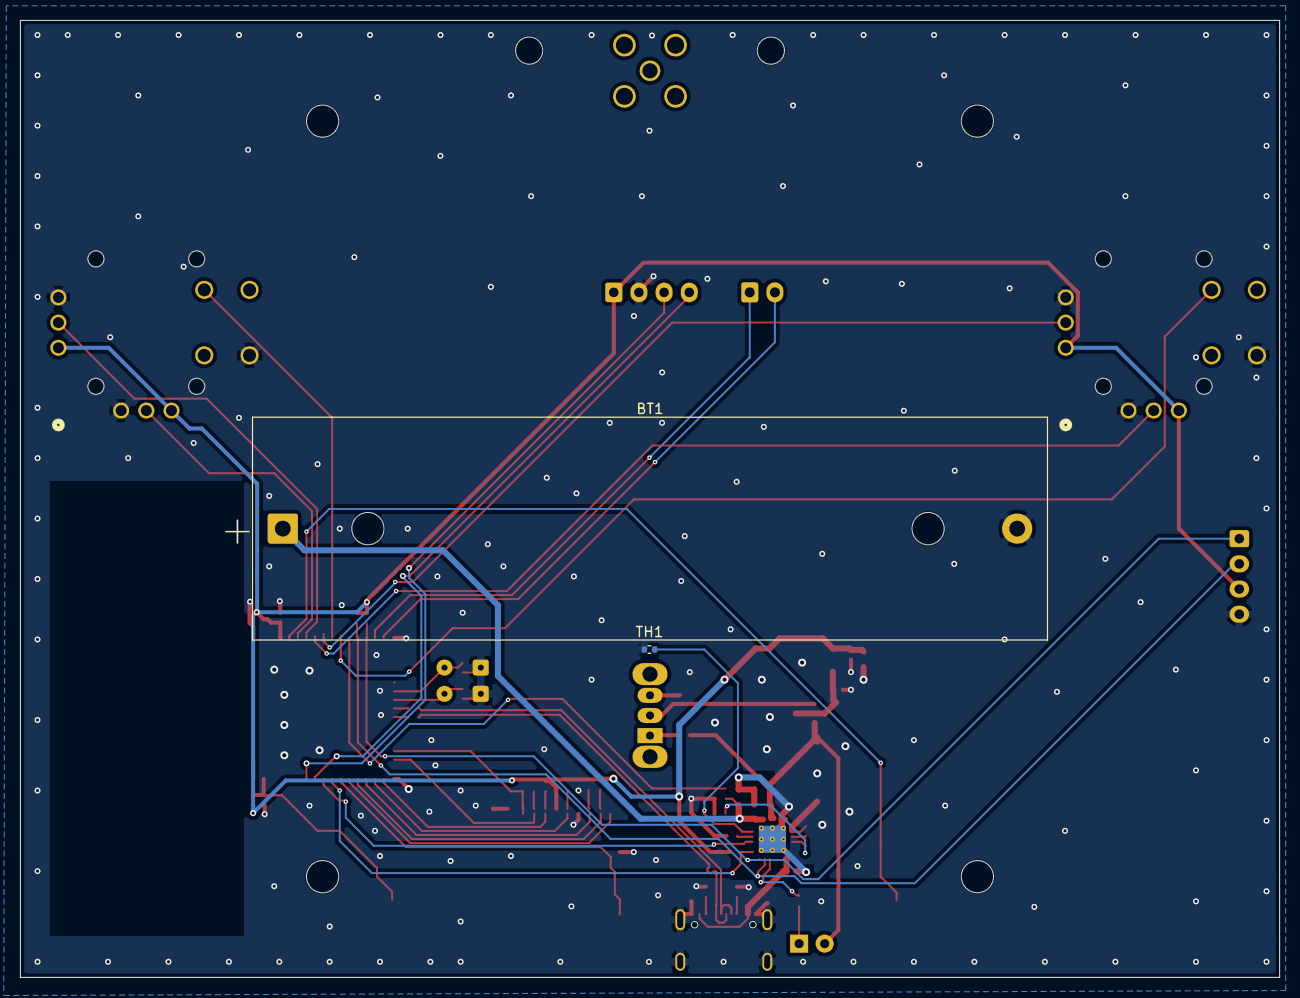
[picture p22: board controller.kicad_pcb from below]

Board: 2 copper layers, 125.0 x 95.0 mm, 59 parts (2 on the bottom side), 49 nets.
