someonelse20/farsight-rc/hardware/transceiver/transceiver.kicad_pcb

## KiCad design hardware/transceiver/transceiver.kicad_pcb (2026-04-02)

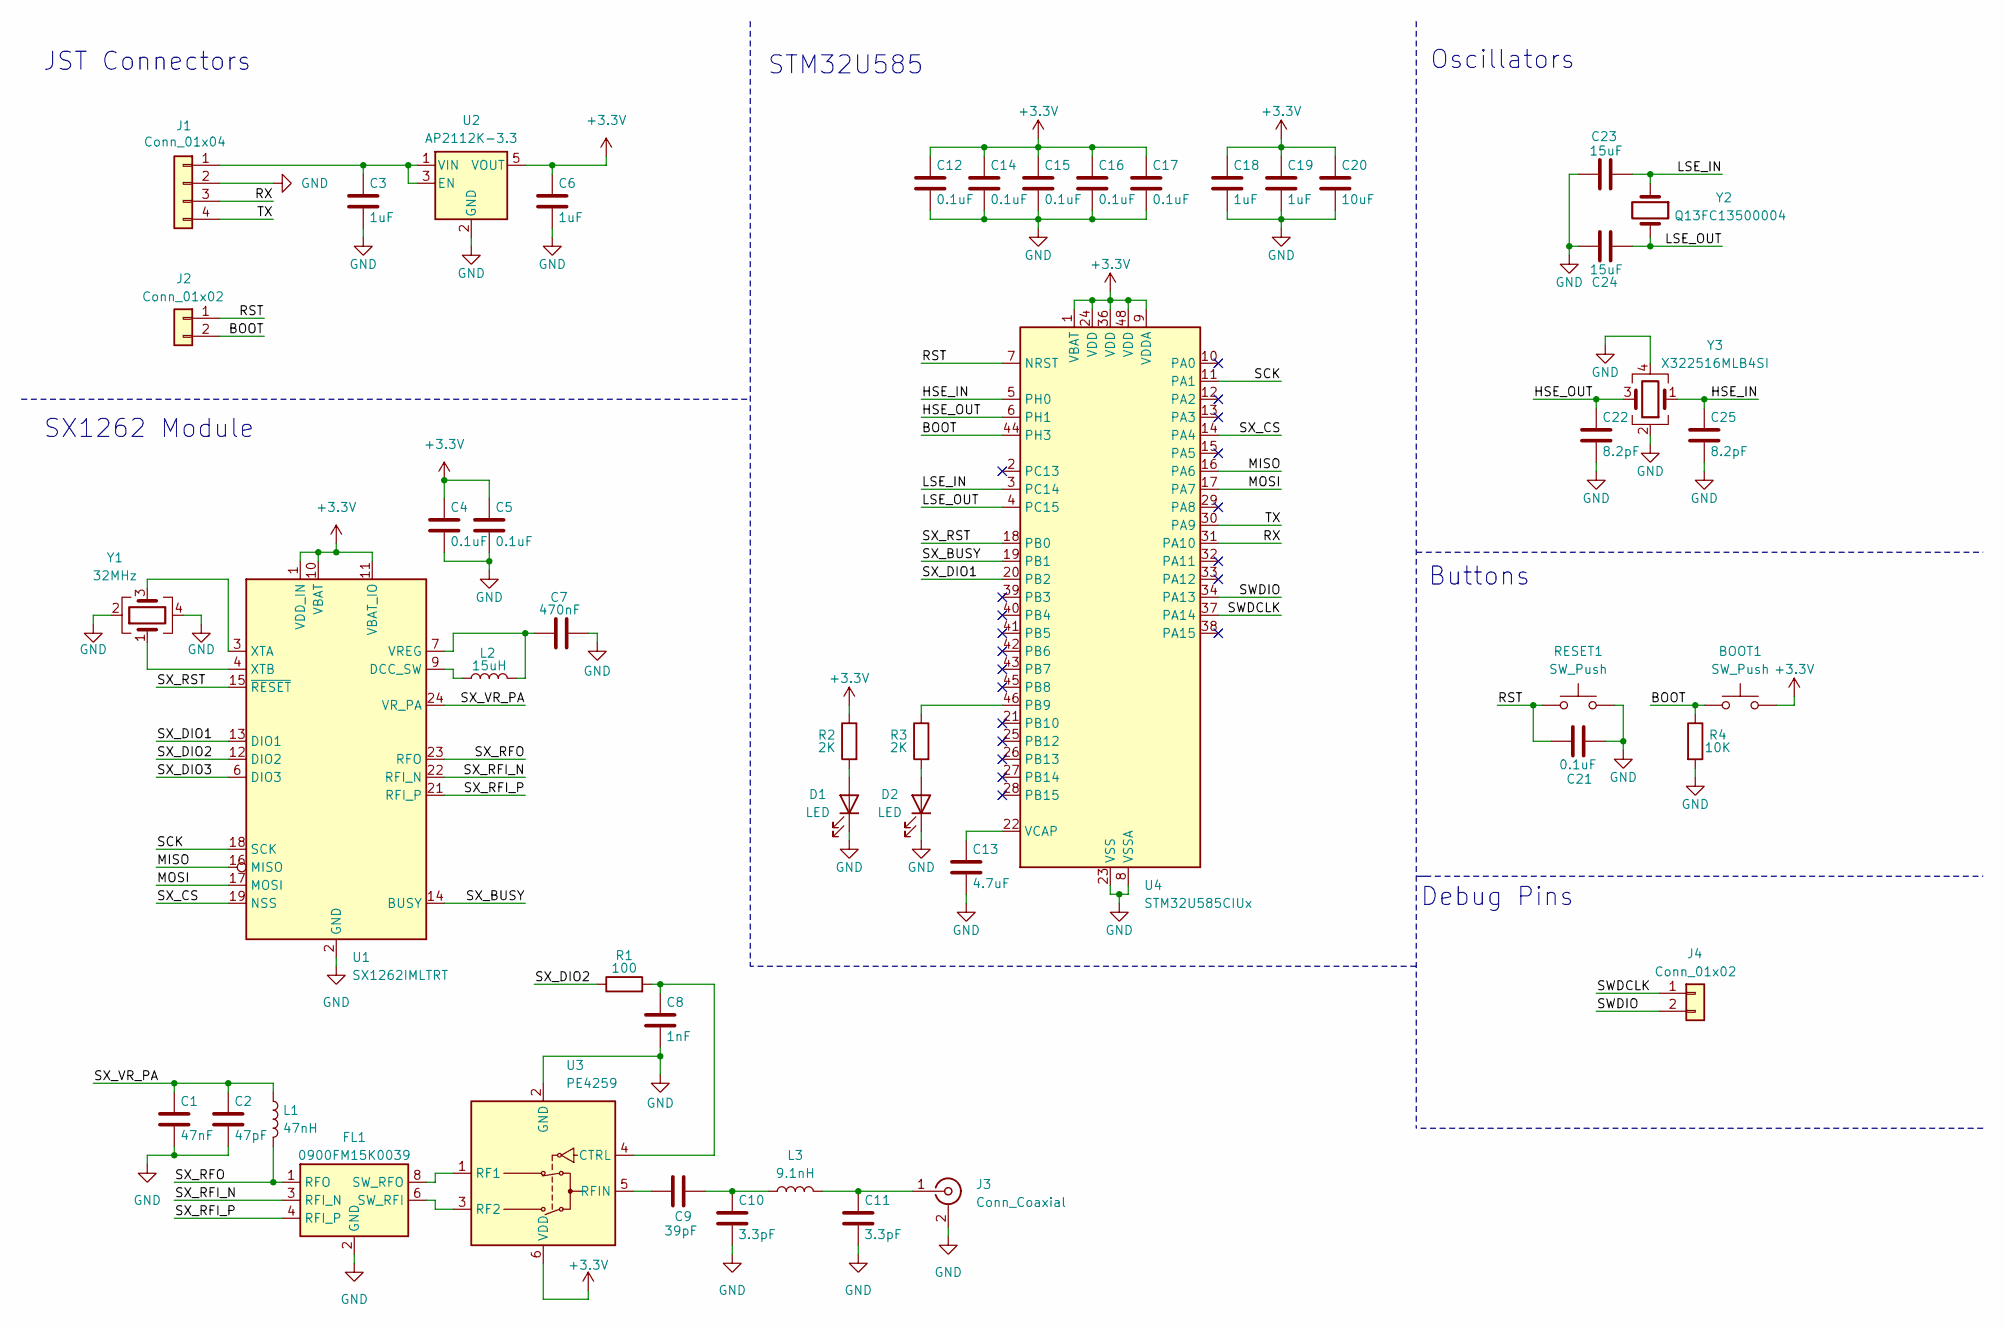
[picture p23: schematic transceiver.kicad_sch]

Parts:
BOOT1: SW_Push; SW_Push_SPST_NO_Alps_SKRK
C1: 47nF; C_0402_1005Metric
C2: 47pF; C_0402_1005Metric
C3, C6, C18, C19: 1uF; C_0603_1608Metric
C4, C5, C12, C14, C15, C16, C17, C21: 0.1uF; C_0402_1005Metric
C7: 470nF; C_0402_1005Metric
C8: 1nF; C_0402_1005Metric
C9: 39pF; C_0402_1005Metric
C10, C11: 3.3pF; C_0402_1005Metric
C13: 4.7uF; C_0402_1005Metric
C20: 10uF; C_0603_1608Metric
C22, C25: 8.2pF; C_0402_1005Metric
C23, C24: 15uF; C_0402_1005Metric
D1, D2: LED; LED_0603_1608Metric
FL1: 0900FM15K0039; Balun_Johanson_0900FM15K0039
J1: Conn_01x04; JST_XH_B4B-XH-A_1x04_P2.50mm_Vertical
J2: Conn_01x02; JST_XH_B2B-XH-A_1x02_P2.50mm_Vertical
J3: Conn_Coaxial; SMA_Amphenol_901-144_Vertical
J4: Conn_01x02; PinHeader_1x02_P2.54mm_Vertical
L1: 47nH; L_0402_1005Metric
L2: 15uH; L_0603_1608Metric
L3: 9.1nH; L_0402_1005Metric
R1: 100; R_0402_1005Metric
R2, R3: 2K; R_0402_1005Metric
R4: 10K; R_0402_1005Metric
RESET1: SW_Push; SW_Push_SPST_NO_Alps_SKRK
U1: SX1262IMLTRT; QFN-24-1EP_4x4mm_P0.5mm_EP2.6x2.6mm
U2: AP2112K-3.3; SOT-23-5
U3: PE4259; SOT-363_SC-70-6
U4: STM32U585CIUx; QFN-48-1EP_7x7mm_P0.5mm_EP5.6x5.6mm
Y1: 32MHz; Crystal_SMD_3225-4Pin_3.2x2.5mm
Y2: Q13FC13500004; Crystal_SMD_3215-2Pin_3.2x1.5mm
Y3: X322516MLB4SI; Crystal_SMD_3225-4Pin_3.2x2.5mm

Connections:
+3.3V: BOOT1.1, C4.1, C5.1, C6.1, C12.1, C14.1, C15.1, C16.1, C17.1, C18.1, C19.1, C20.1, R2.1, U1.1 (VDD_IN), U1.10 (VBAT), U1.11 (VBAT_IO), U2.5 (VOUT), U3.6 (VDD), U4.1 (VBAT), U4.9 (VDDA), U4.24 (VDD), U4.36 (VDD), U4.48 (VDD)
/BOOT: BOOT1.2, J2.2, R4.1, U4.44 (PH3)
/HSE_IN: C25.1, U4.5 (PH0), Y3.1
/HSE_OUT: C22.1, U4.6 (PH1), Y3.3
/LSE_IN: C23.2, U4.3 (PC14), Y2.1
/LSE_OUT: C24.1, U4.4 (PC15), Y2.2
/MISO: U1.16 (MISO), U4.16 (PA6)
/MOSI: U1.17 (MOSI), U4.17 (PA7)
/RST: C21.2, J2.1, RESET1.2, U4.7 (NRST)
/RX: J1.3, U4.31 (PA10)
/SCK: U1.18 (SCK), U4.11 (PA1)
/SWDCLK: J4.1, U4.37 (PA14)
/SWDIO: J4.2, U4.34 (PA13)
/SX_BUSY: U1.14 (BUSY), U4.19 (PB1)
/SX_CS: U1.19 (NSS), U4.14 (PA4)
/SX_DIO1: U1.13 (DIO1), U4.20 (PB2)
/SX_DIO2: R1.1, U1.12 (DIO2)
/SX_DIO3: U1.6 (DIO3)
/SX_RFI_N: FL1.3 (RFI_N), U1.22 (RFI_N)
/SX_RFI_P: FL1.4 (RFI_P), U1.21 (RFI_P)
/SX_RFO: FL1.1 (RFO), L1.2, U1.23 (RFO)
/SX_RST: U1.15 (~RESET), U4.18 (PB0)
/SX_VR_PA: C1.1, C2.1, L1.1, U1.24 (VR_PA)
/TX: J1.4, U4.30 (PA9)
GND: C1.2, C2.2, C3.2, C4.2, C5.2, C6.2, C7.2, C8.2, C10.2, C11.2, C12.2, C13.2, C14.2, C15.2, C16.2, C17.2, C18.2, C19.2, C20.2, C21.1, C22.2, C23.1, C24.2, C25.2, D1.1 (K), D2.1 (K), FL1.2 (GND), FL1.5 (GND), FL1.7 (GND), FL1.9 (GND), FL1.10 (GND), J1.2, J3.2 (Ext), R4.2, RESET1.1, U1.2 (GND), U1.5 (GND), U1.8 (GND), U1.20 (GND), U1.25 (GND), U2.2 (GND), U3.2 (GND), U4.8 (VSSA), U4.23 (VSS), U4.35 (VSS), U4.47 (VSS), U4.49 (VSS), Y1.2, Y1.4, Y3.2, Y3.4
unnamed: C9.2, C10.1, L3.1
unnamed: D1.2 (A), R2.2
unnamed: D2.2 (A), R3.2
unnamed: FL1.6 (SW_RFI), U3.3 (RF2)
unnamed: FL1.8 (SW_RFO), U3.1 (RF1)
unnamed: C3.1, J1.1, U2.1 (VIN), U2.3 (EN)
unnamed: C11.1, J3.1 (In), L3.2
unnamed: L2.1, U1.9 (DCC_SW)
unnamed: C7.1, L2.2, U1.7 (VREG)
unnamed: U1.3 (XTA), Y1.3
unnamed: U1.4 (XTB), Y1.1
unnamed: C8.1, R1.2, U3.4 (CTRL)
unnamed: C9.1, U3.5 (RFIN)
unnamed: R3.1, U4.46 (PB9)
unnamed: C13.1, U4.22 (VCAP)

Notes on the sheet:
STM32U585
Buttons
SX1262 Module
Debug Pins
JST Connectors
Oscillators

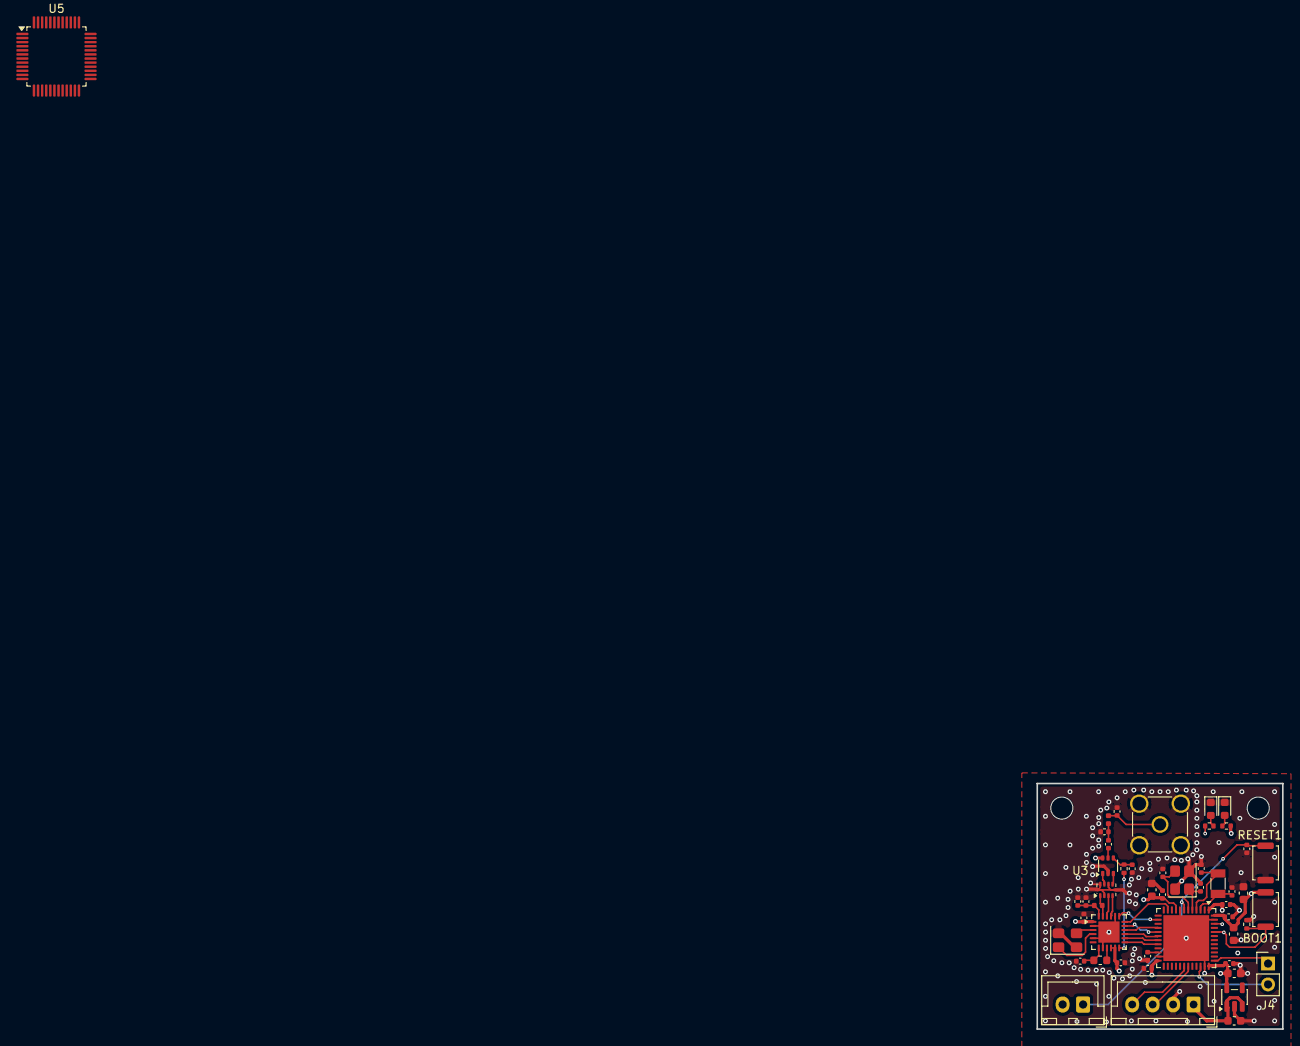
[picture p24: board transceiver.kicad_pcb from above]

Board: 4 copper layers, 30.0 x 30.0 mm, 49 parts (0 on the bottom side), 40 nets.

Other parts of the board:
U5: STM32U585CITx; LQFP-48_7x7mm_P0.5mm

Their connections:
unnamed: U5.23 (VSS), U5.35 (VSS), U5.47 (VSS)
