someonelse20/farsight-rc/software/transceiver/transceiver.ioc

Mcu.UserName=STM32U535CCUx
PA1.Signal=SPI1_SCK
PA10.Signal=USART1_RX
PA4.Signal=SPI1_NSS
PA6.Signal=SPI1_MISO
PA7.Signal=SPI1_MOSI
PA9.Signal=USART1_TX
PB0.Signal=GPIO_Output
PB1.Signal=GPIO_Input
PB2.Signal=GPXTI2
PB9.Signal=GPIO_Output
