someonelse20/farsight-rc/software/controller/main/softap.c

/*  WiFi softAP Example

   This example code is in the Public Domain (or CC0 licensed, at your option.)

   Unless required by applicable law or agreed to in writing, this
   software is distributed on an "AS IS" BASIS, WITHOUT WARRANTIES OR
   CONDITIONS OF ANY KIND, either express or implied.
 */
#include <string.h>
#include "softap.h"
#include "freertos/FreeRTOS.h"
#include "freertos/task.h"
#include "esp_mac.h"
#include "esp_wifi.h"
#include "esp_event.h"
#include "esp_log.h"
#include "nvs_flash.h"

#include "lwip/err.h"
#include "lwip/sys.h"

/* The examples use WiFi configuration that you can set via project configuration menu.

   If you'd rather not, just change the below entries to strings with
   the config you want - ie #define EXAMPLE_WIFI_SSID "mywifissid"
 */
#define EXAMPLE_ESP_WIFI_SSID      CONFIG_ESP_WIFI_SSID
#define EXAMPLE_ESP_WIFI_PASS      CONFIG_ESP_WIFI_PASSWORD
#define EXAMPLE_ESP_WIFI_CHANNEL   CONFIG_ESP_WIFI_CHANNEL
#define EXAMPLE_MAX_STA_CONN       CONFIG_ESP_MAX_STA_CONN

#if CONFIG_ESP_GTK_REKEYING_ENABLE
#define EXAMPLE_GTK_REKEY_INTERVAL CONFIG_ESP_GTK_REKEY_INTERVAL
#else
#define EXAMPLE_GTK_REKEY_INTERVAL 0
#endif

static const char *TAG = "WIFI softAP";

static void wifi_event_handler(void* arg, esp_event_base_t event_base,
                               int32_t event_id, void* event_data)
{
	if (event_id == WIFI_EVENT_AP_STACONNECTED) {
		wifi_event_ap_staconnected_t* event = (wifi_event_ap_staconnected_t*) event_data;
		ESP_LOGI(TAG, "station "MACSTR" join, AID=%d",
		         MAC2STR(event->mac), event->aid);
	} else if (event_id == WIFI_EVENT_AP_STADISCONNECTED) {
		wifi_event_ap_stadisconnected_t* event = (wifi_event_ap_stadisconnected_t*) event_data;
		ESP_LOGI(TAG, "station "MACSTR" leave, AID=%d, reason=%d",
		         MAC2STR(event->mac), event->aid, event->reason);
	}
}

void wifi_init_softap(void)
{
	ESP_ERROR_CHECK(esp_netif_init());
	ESP_ERROR_CHECK(esp_event_loop_create_default());
	esp_netif_create_default_wifi_ap();

	wifi_init_config_t cfg = WIFI_INIT_CONFIG_DEFAULT();
	ESP_ERROR_CHECK(esp_wifi_init(&cfg));

	ESP_ERROR_CHECK(esp_event_handler_instance_register(WIFI_EVENT,
	                                                    ESP_EVENT_ANY_ID,
	                                                    &wifi_event_handler,
	                                                    NULL,
	                                                    NULL));

	wifi_config_t wifi_config = {
		.ap = {
			.ssid = EXAMPLE_ESP_WIFI_SSID,
			.ssid_len = strlen(EXAMPLE_ESP_WIFI_SSID),
			.channel = EXAMPLE_ESP_WIFI_CHANNEL,
			.password = EXAMPLE_ESP_WIFI_PASS,
			.max_connection = EXAMPLE_MAX_STA_CONN,
#ifdef CONFIG_ESP_WIFI_SOFTAP_SAE_SUPPORT
			.authmode = WIFI_AUTH_WPA3_PSK,
			.sae_pwe_h2e = WPA3_SAE_PWE_BOTH,
#else /* CONFIG_ESP_WIFI_SOFTAP_SAE_SUPPORT */
			.authmode = WIFI_AUTH_WPA2_PSK,
#endif
			.pmf_cfg = {
				.required = true,
			},
#ifdef CONFIG_ESP_WIFI_BSS_MAX_IDLE_SUPPORT
			.bss_max_idle_cfg = {
				.period = WIFI_AP_DEFAULT_MAX_IDLE_PERIOD,
				.protected_keep_alive = 1,
			},
#endif
			.gtk_rekey_interval = EXAMPLE_GTK_REKEY_INTERVAL,
		},
	};
	if (strlen(EXAMPLE_ESP_WIFI_PASS) == 0) {
		wifi_config.ap.authmode = WIFI_AUTH_OPEN;
	}

	ESP_ERROR_CHECK(esp_wifi_set_mode(WIFI_MODE_AP));
	ESP_ERROR_CHECK(esp_wifi_set_config(WIFI_IF_AP, &wifi_config));
	ESP_ERROR_CHECK(esp_wifi_start());

	ESP_LOGI(TAG, "wifi_init_softap finished. SSID:%s password:%s channel:%d",
	         EXAMPLE_ESP_WIFI_SSID, EXAMPLE_ESP_WIFI_PASS, EXAMPLE_ESP_WIFI_CHANNEL);
}

/*
   void app_main(void)
   {
    //Initialize NVS
    esp_err_t ret = nvs_flash_init();
    if (ret == ESP_ERR_NVS_NO_FREE_PAGES || ret == ESP_ERR_NVS_NEW_VERSION_FOUND) {
      ESP_ERROR_CHECK(nvs_flash_erase());
      ret = nvs_flash_init();
    }
    ESP_ERROR_CHECK(ret);

    ESP_LOGI(TAG, "ESP_WIFI_MODE_AP");
    wifi_init_softap();
   }
 */
