someonelse20/farsight-rc/(commit log)

2026-02-08 started wiring schematic
    [ESP32_Module.kicad_sch, controller.kicad_pcb, controller.kicad_sch]
2026-02-09 finished schematic
    [controller.kicad_pcb, controller.kicad_sch, untitled.kicad_sch, untitled2.kicad_sch]
2026-02-09 added footprints
    [controller.kicad_sch]
2026-02-09 added footprints and started layout
    [controller.kicad_pcb, controller.kicad_sch]
2026-02-09 routing board
    [ESP32_Module.kicad_sch, controller.kicad_pcb, controller.kicad_sch, untitled.kicad_sch, untitled2.kicad_sch]
2026-02-14 finished first version
    [controller.kicad_pcb, controller.kicad_sch]
2026-02-14 finished board
    [controller.kicad_pcb, controller.kicad_sch]
2026-02-16 started cad
    [controller.kicad_pcb, controller.step, shell.FCStd, top_shell.3mf, top_shell.FCStd]
2026-02-18 added tranceiver and joystick
    [bottom_shell.3mf, bottom_shell.FCStd, controller.kicad_pcb, controller.kicad_sch, joystick_cap.3mf, joystick_cap.FCStd, shell.FCStd, test-Body.3mf]
2026-02-20 added oled driver
2026-02-21 redesigned tranceiver
    [transceiver.kicad_pcb, transceiver.kicad_sch]
2026-02-22 updated controller pcb
    [controller.kicad_pcb, controller.kicad_sch]
2026-02-22 cleaning up transceiver
    [transceiver.kicad_pcb, transceiver.kicad_sch]
2026-02-22 cleaning up controller pcb
    [controller.kicad_pcb, controller.kicad_sch]
2026-02-24 added print
2026-02-24 updated cad
    [bottom_shell.FCStd, controller.kicad_pcb, shell.FCStd, top_shell.FCStd, transceiver.kicad_pcb, transceiver.step]
2026-02-24 touching up hardware
    [shell.FCStd]
2026-02-26 updated joystick
    [joystick_cap.3mf, joystick_cap.FCStd, shell.FCStd]
2026-02-26 added lines to schematic
    [controller.kicad_sch]
2026-02-28 changing uart communication
2026-02-28 changed switch circuit
    [controller.kicad_pcb, controller.kicad_sch]
2026-03-02 fixing switch
2026-03-02 added uart protocol
2026-03-02 fixed switch and joysticks
    [controller.kicad_pcb, controller.kicad_sch, shell.FCStd, top_shell.FCStd]
2026-03-02 fixed switch and joystick
2026-03-03 moved reg.c/h to uart_reg.c/h
2026-03-03 fixed sx126x hal read
    [main.c]
2026-03-03 added SWD to transceiver
    [transceiver.kicad_pcb, transceiver.kicad_sch]
2026-03-05 fixed usb
    [controller.kicad_pcb, controller.kicad_sch]
2026-03-05 added assets
    [shell.FCStd, top_shell.FCStd, transceiver.kicad_pcb]
2026-03-05 changed boot1 and reset1 to boot and reset
    [transceiver.kicad_pcb, transceiver.kicad_sch]
2026-03-07 Update BOM
2026-03-07 Updated BOM
2026-03-07 added production files
    [bom.csv, bottom_shell.step, controller.kicad_pcb, controller.kicad_sch, designators.csv, joystick_cap.step, positions.csv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]
2026-03-07 added bom.csv
    [bom.csv]
2026-03-08 added version to silkscreen
    [bom.csv, controller.kicad_pcb, positions.csv, transceiver.kicad_pcb]
2026-03-08 Added display to BOM
2026-03-08 added oled to bom
    [bom.csv]
2026-03-30 rewrote firmware
    [controller.kicad_pcb, positions.csv, transceiver.kicad_pcb]
2026-03-30 writing adc
2026-03-30 added adc polling
2026-04-02 updated to kicad 10
    [controller.kicad_pcb, controller.kicad_sch, transceiver.kicad_pcb, transceiver.kicad_sch]
2026-04-02 changed to stm32u535cc
